JanDrska/FIRESPORT-WATCH/HW/Photo/HW/TEST_HW_2.jpeg

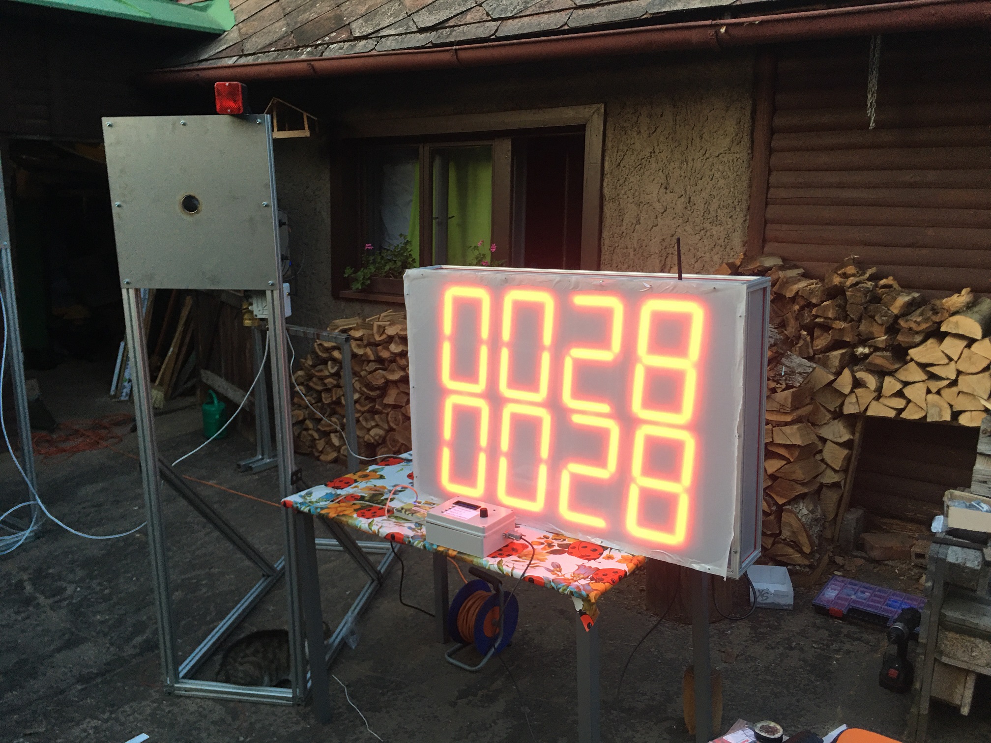
HW/Photo/HW/TEST_HW_2.jpeg
