JanDrska/FIRESPORT-WATCH/HW/Photo/HW/DETAIL NA UTESNENI.jpeg

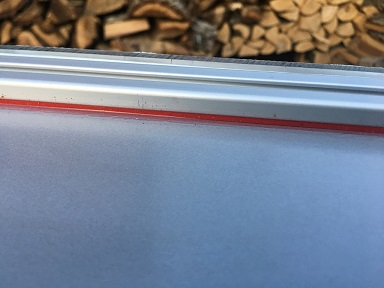
HW/Photo/HW/DETAIL NA UTESNENI.jpeg
