JanDrska/FIRESPORT-WATCH/README.md

# FIRESPORT-WATCH
OpenSource project based on arduino which allows better time measuring and adds some extras features.
