JanDrska/FIRESPORT-WATCH/HW/Eagle PCBs/7SEGMENT/7SEGMENT_SCH.png

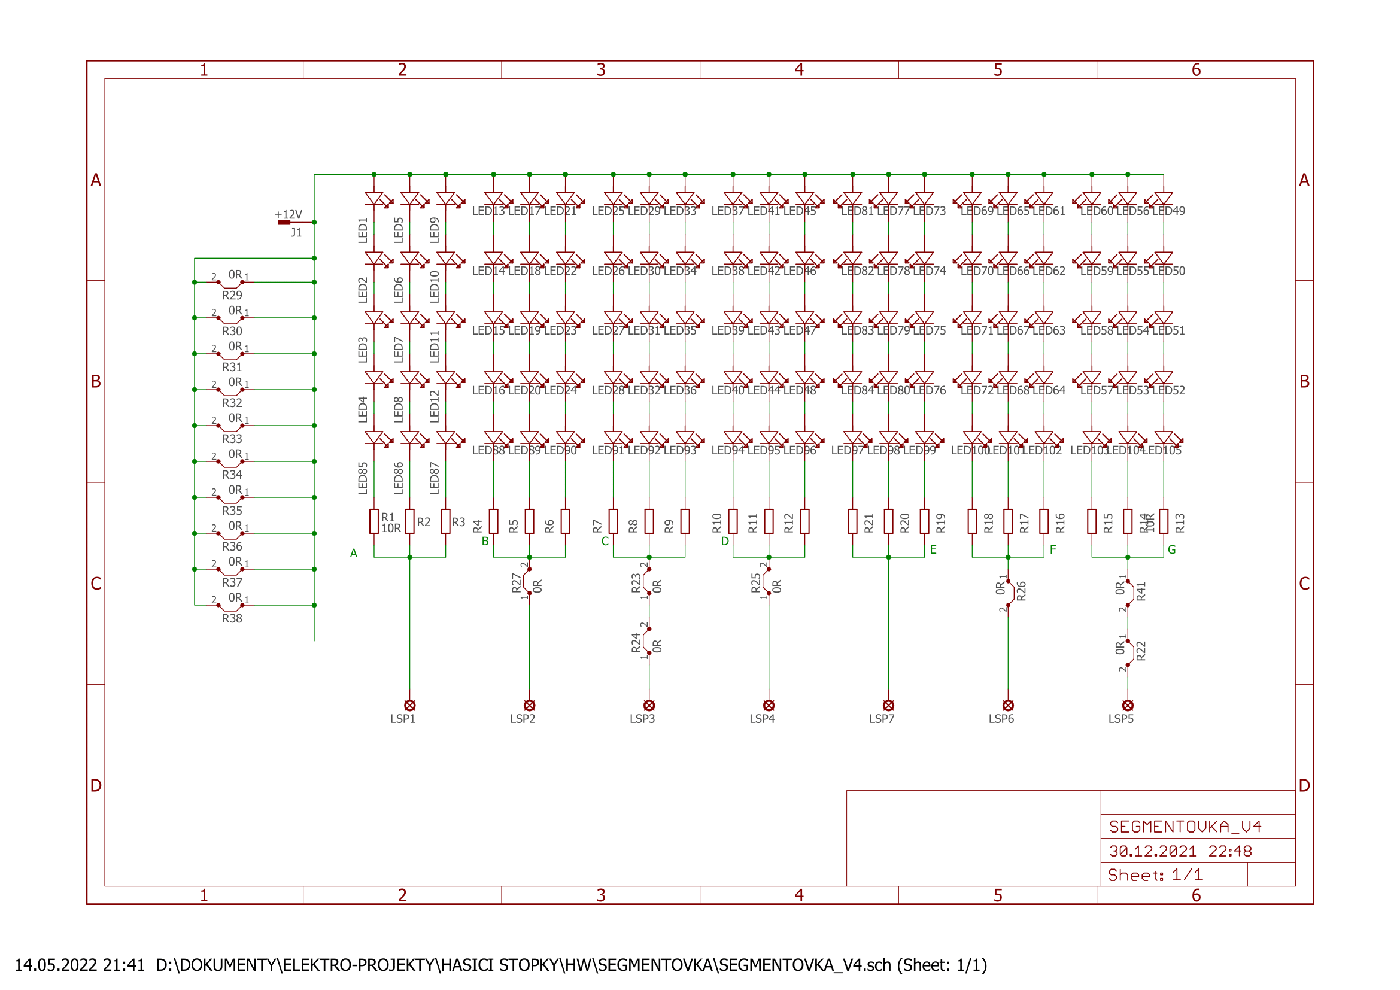
HW/Eagle PCBs/7SEGMENT/7SEGMENT_SCH.png
