JanDrska/FIRESPORT-WATCH/HW/Eagle PCBs/7SEGMENT/7SEGMENT_TOP.png

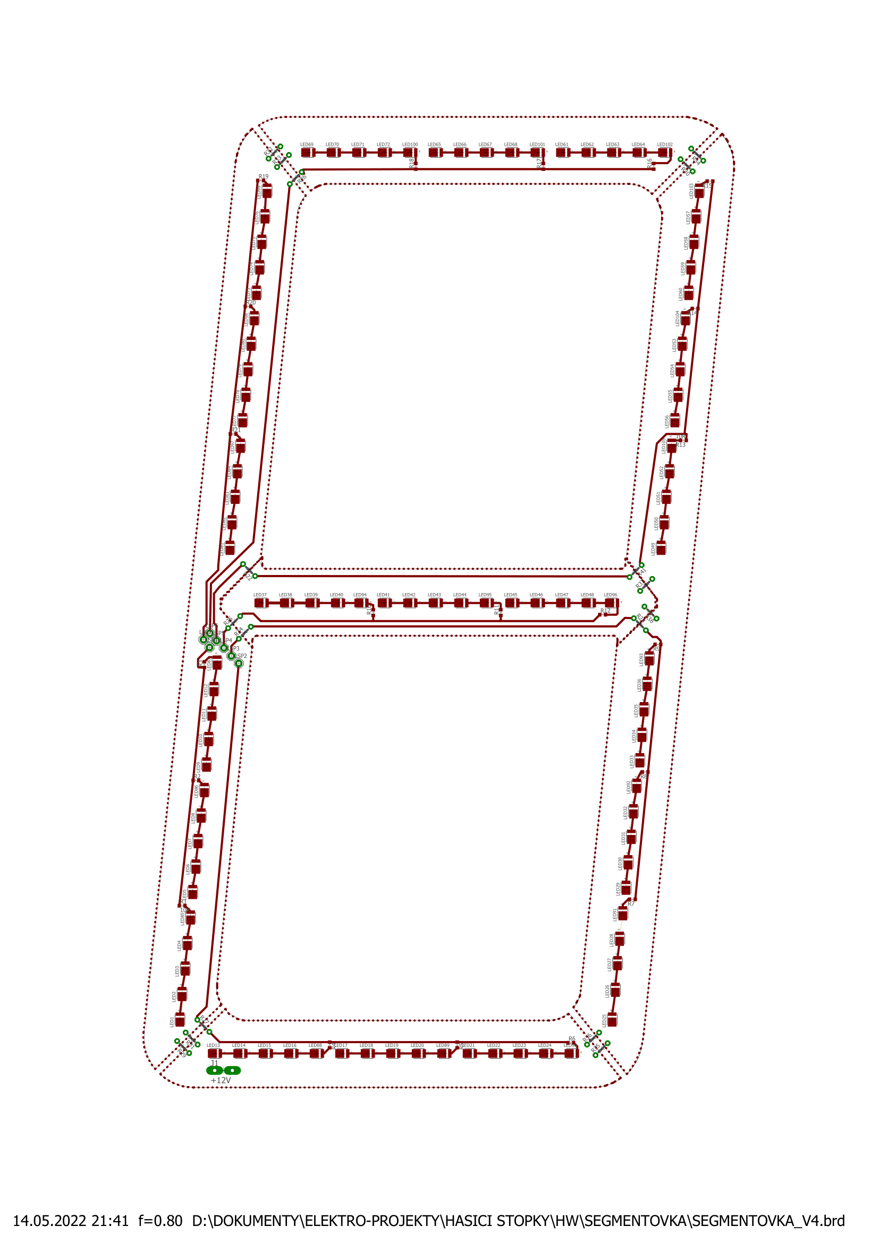
HW/Eagle PCBs/7SEGMENT/7SEGMENT_TOP.png
