JanDrska/FIRESPORT-WATCH/HW/Eagle PCBs/CONTROL_PANEL/CTRL_PANEL_SCH.png

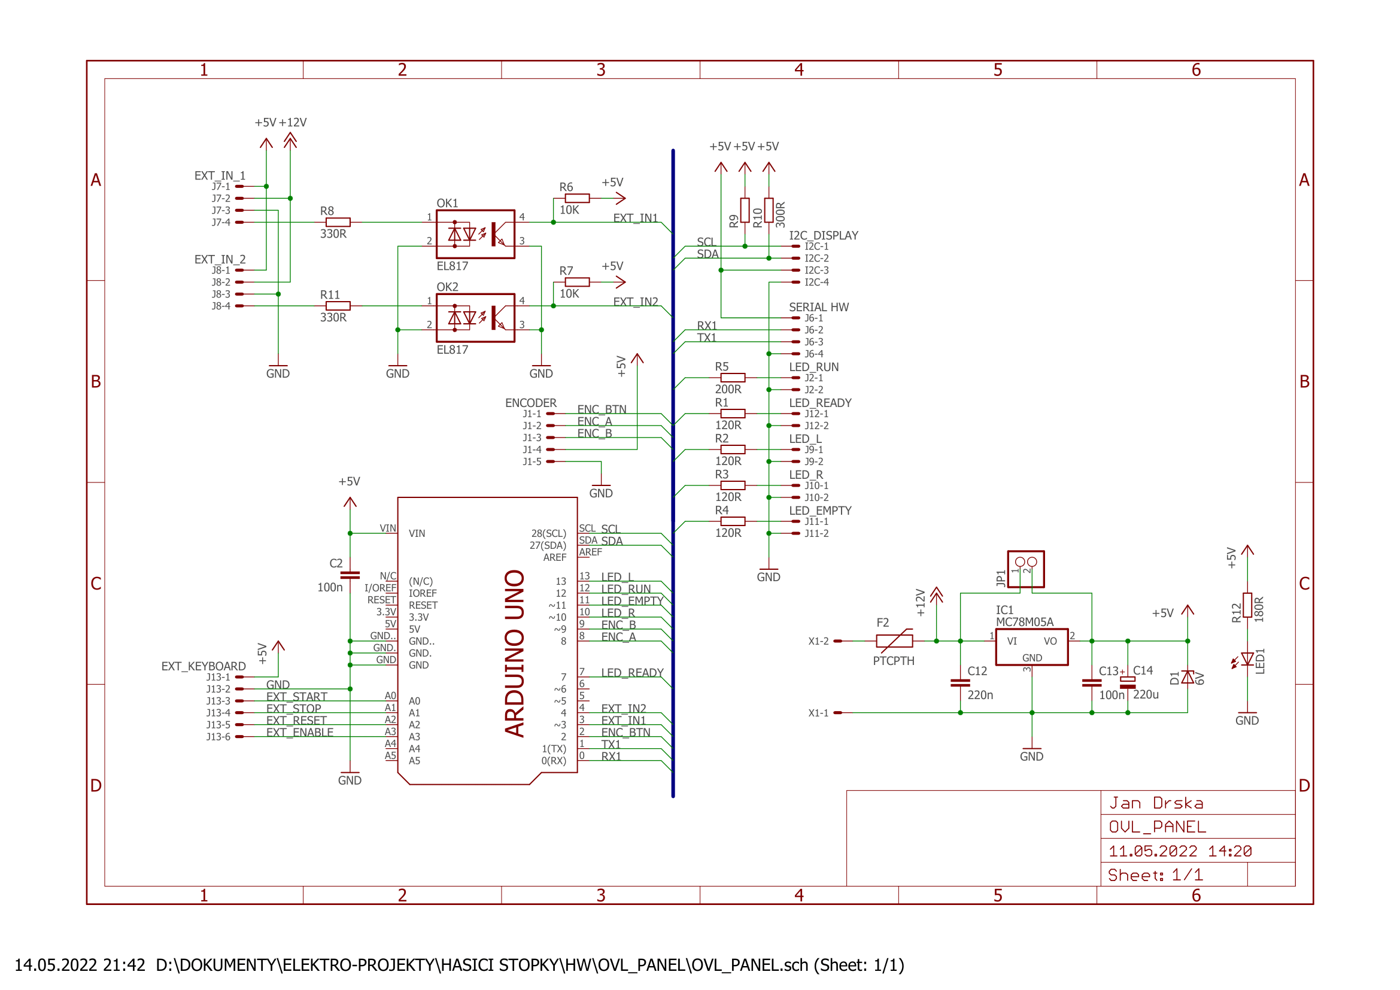
HW/Eagle PCBs/CONTROL_PANEL/CTRL_PANEL_SCH.png
