JanDrska/FIRESPORT-WATCH/HW/Eagle PCBs/CONTROL_PANEL/CTRL_PANEL_TOP_BOT.png

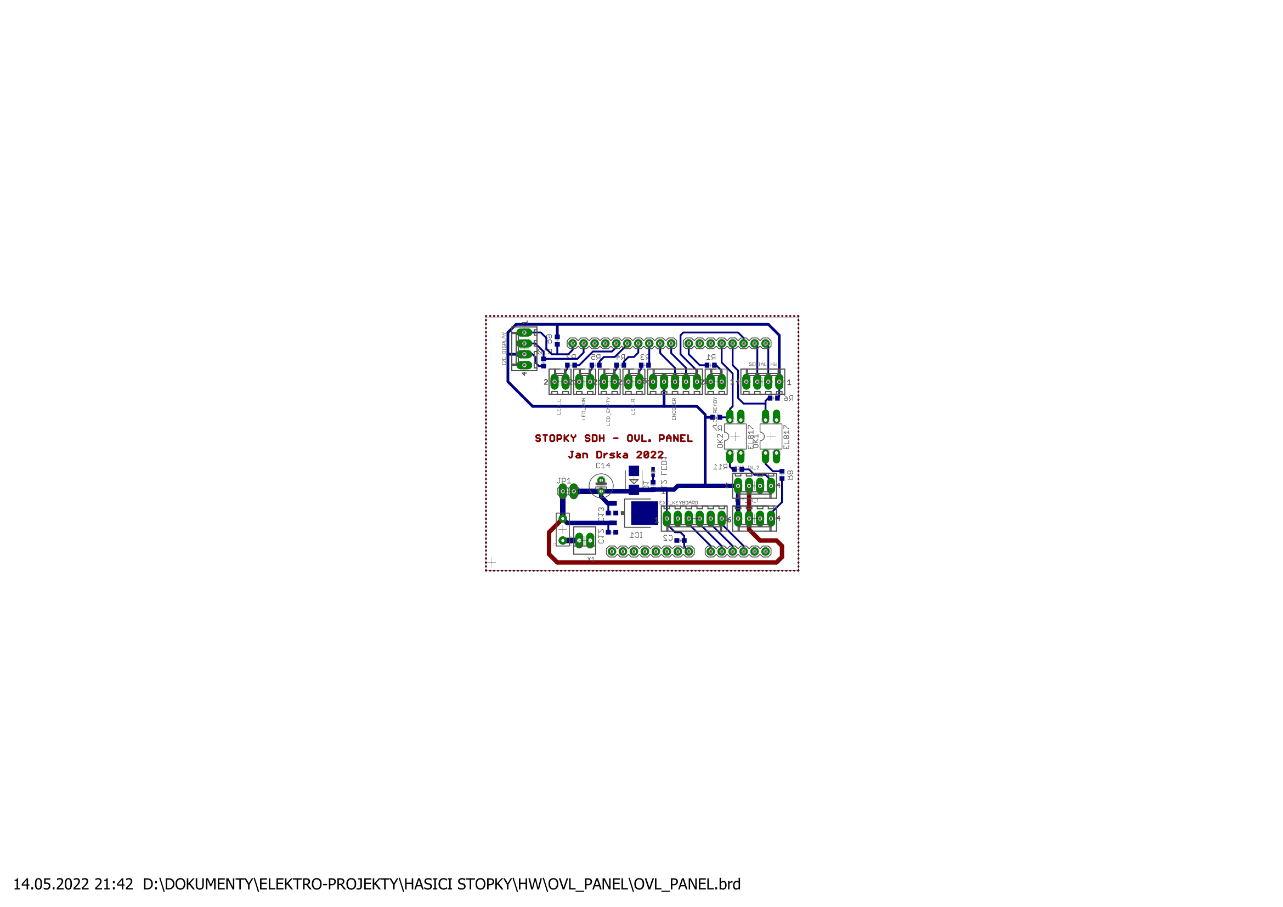
HW/Eagle PCBs/CONTROL_PANEL/CTRL_PANEL_TOP_BOT.png
