JanDrska/FIRESPORT-WATCH/HW/Eagle PCBs/I2C_MODULE/I2C_BOT_TOP.png

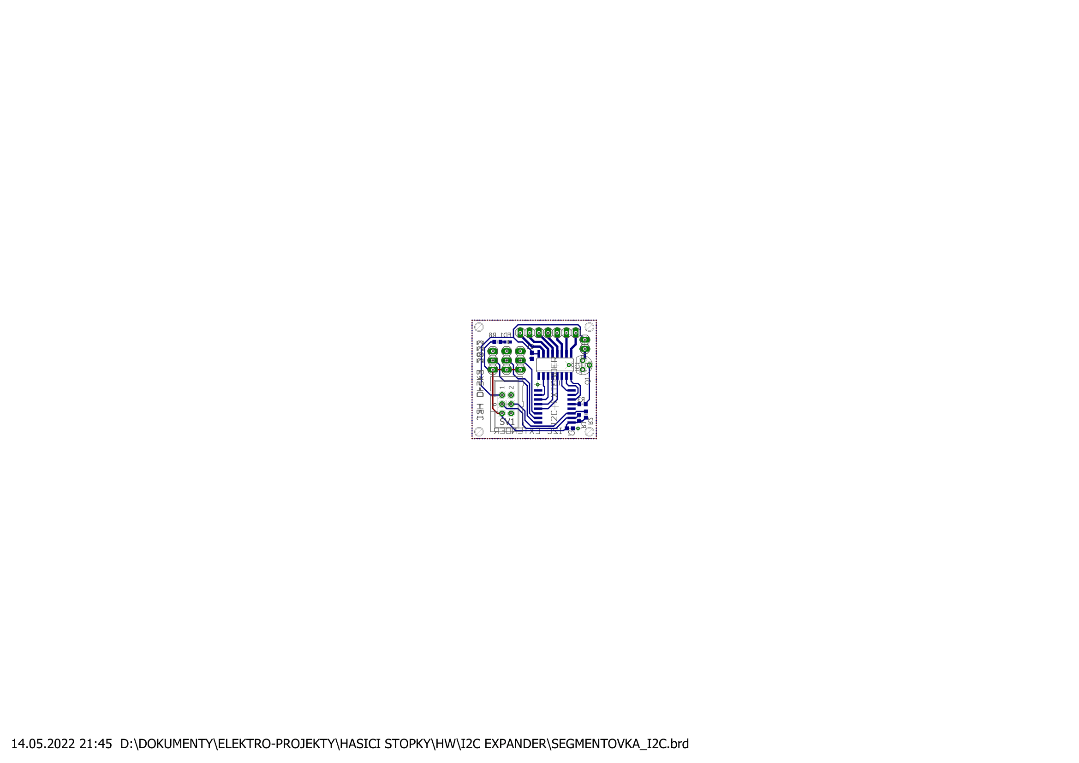
HW/Eagle PCBs/I2C_MODULE/I2C_BOT_TOP.png
