JanDrska/FIRESPORT-WATCH/HW/Eagle PCBs/I2C_MODULE/I2C_SCH.png

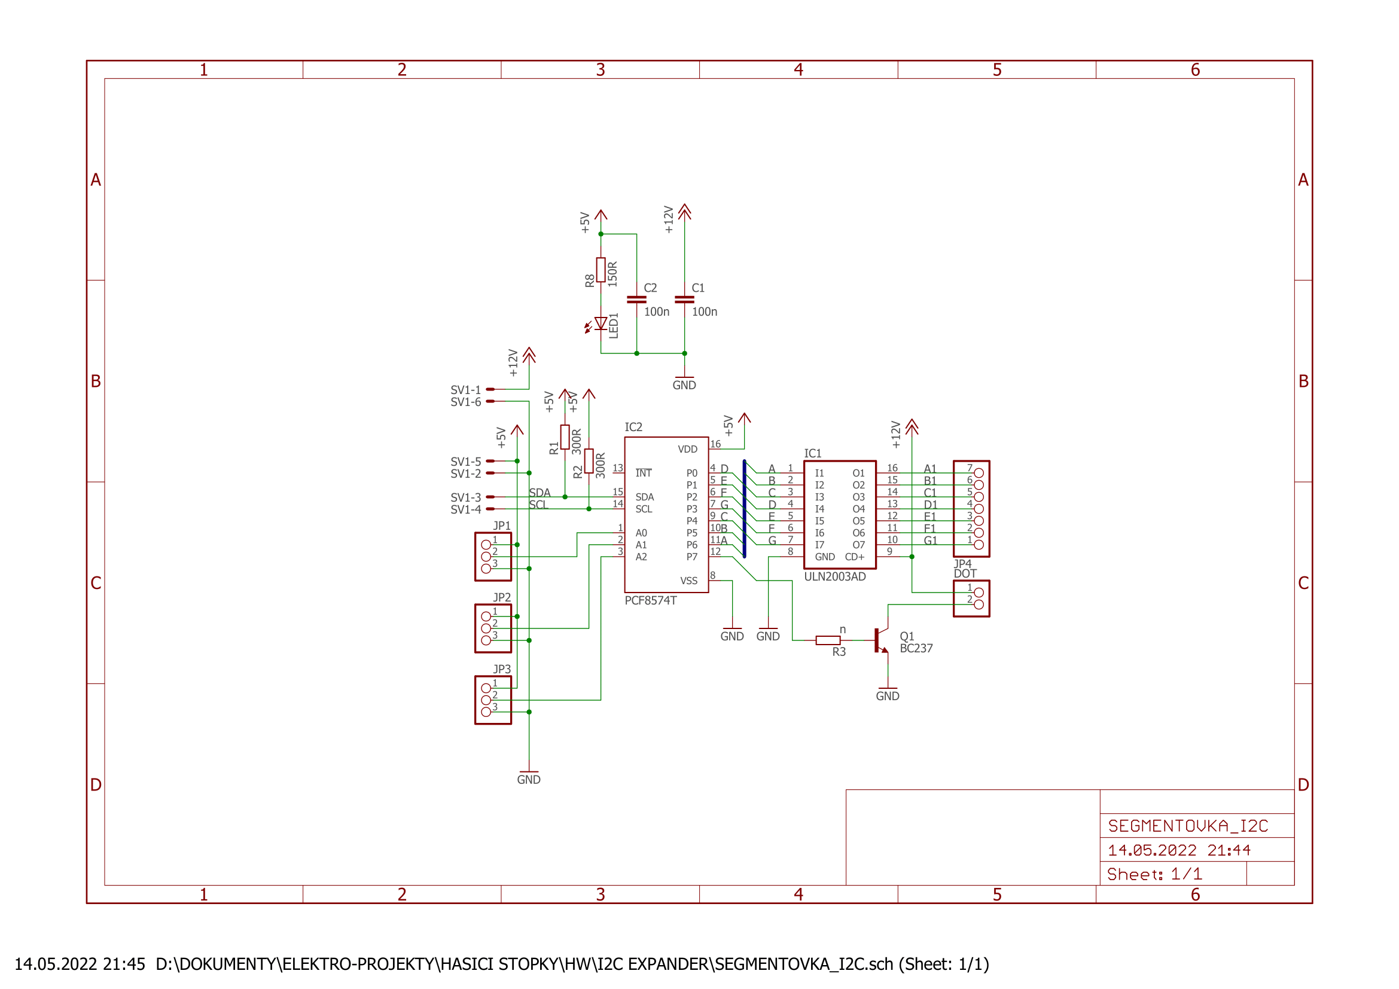
HW/Eagle PCBs/I2C_MODULE/I2C_SCH.png
