JanDrska/FIRESPORT-WATCH/HW/Eagle PCBs/MAIN UNIT/MAIN_UNIT_BOT.png

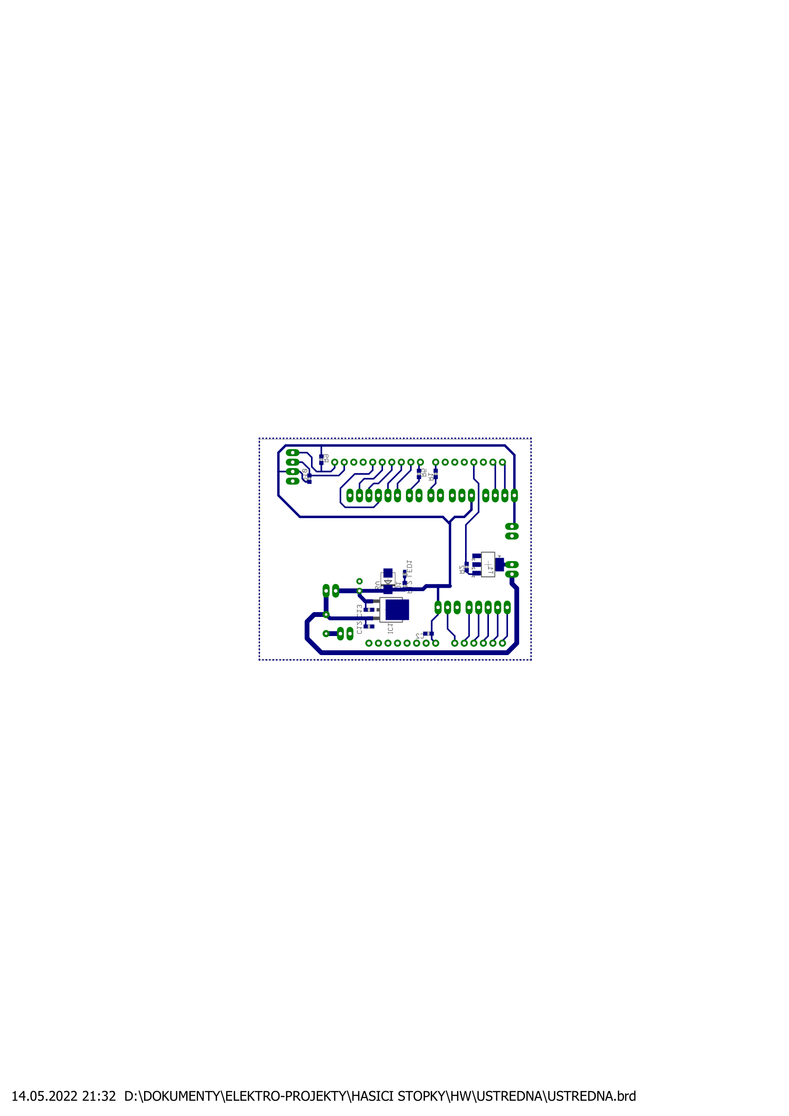
HW/Eagle PCBs/MAIN UNIT/MAIN_UNIT_BOT.png
