JanDrska/FIRESPORT-WATCH/HW/Eagle PCBs/MAIN UNIT/MAIN_UNIT_SCH.png

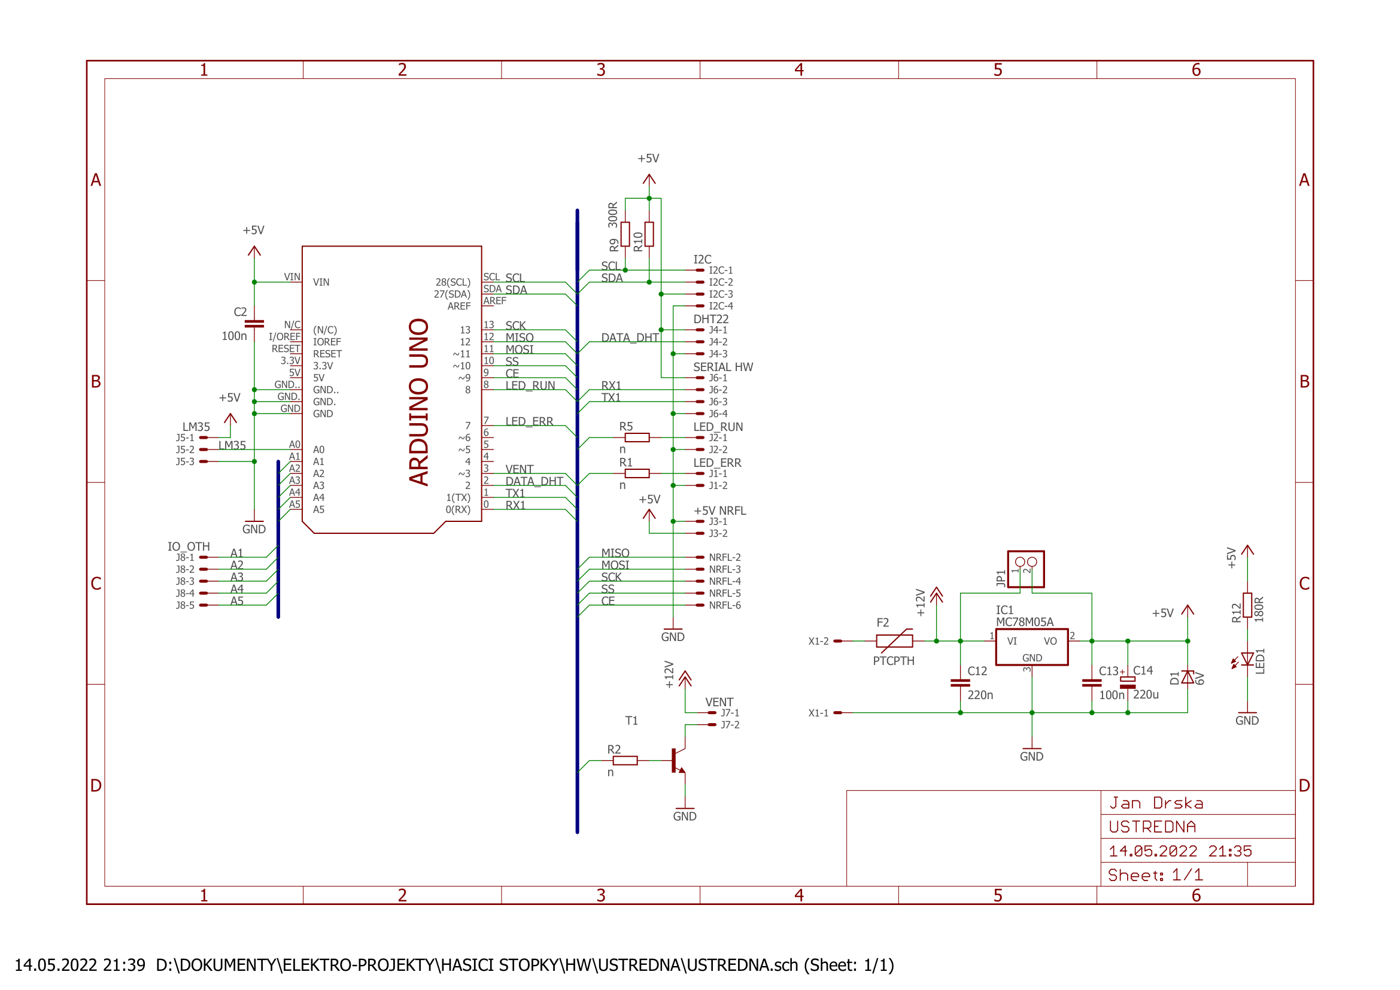
HW/Eagle PCBs/MAIN UNIT/MAIN_UNIT_SCH.png
