JanDrska/FIRESPORT-WATCH/HW/Eagle PCBs/TARGETS/TARGET_SCH.png

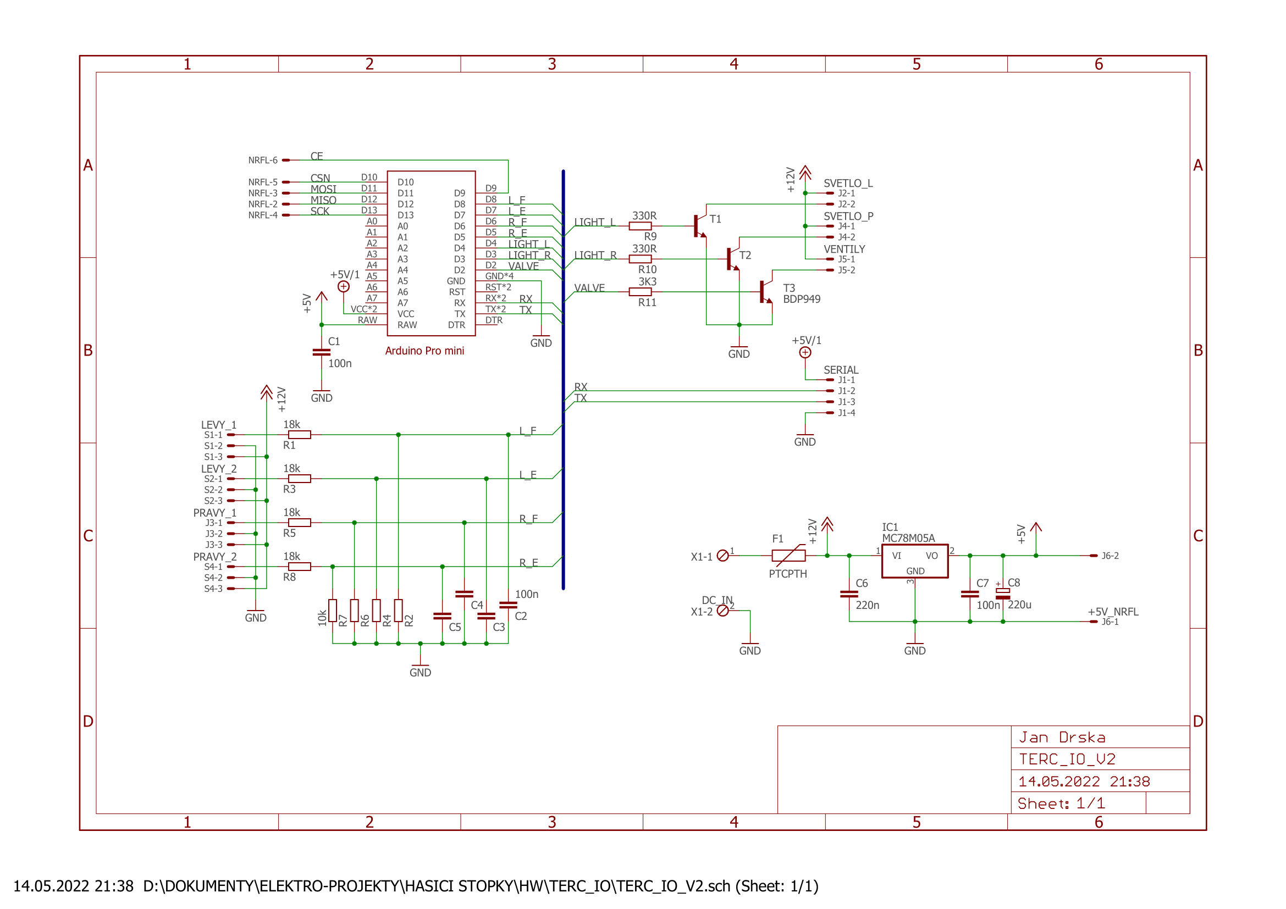
HW/Eagle PCBs/TARGETS/TARGET_SCH.png
