JanDrska/FIRESPORT-WATCH/HW/Photo/3D MODELS/DIFUZOR_V4.png

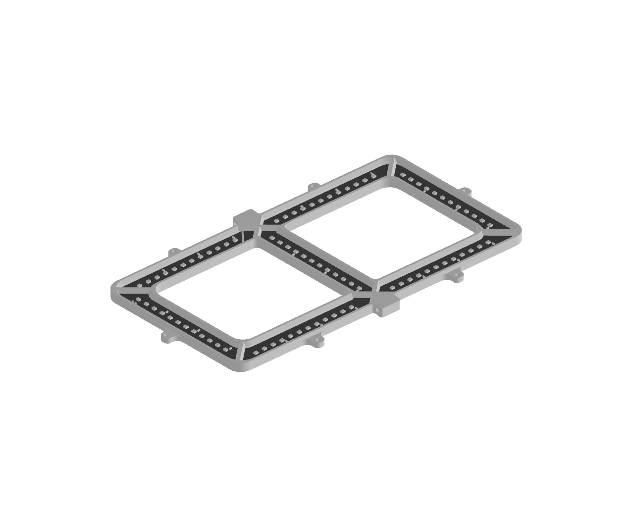
HW/Photo/3D MODELS/DIFUZOR_V4.png
