JanDrska/FIRESPORT-WATCH/HW/Photo/3D MODELS/OVLADACI_PANEL_KOMPLET.png

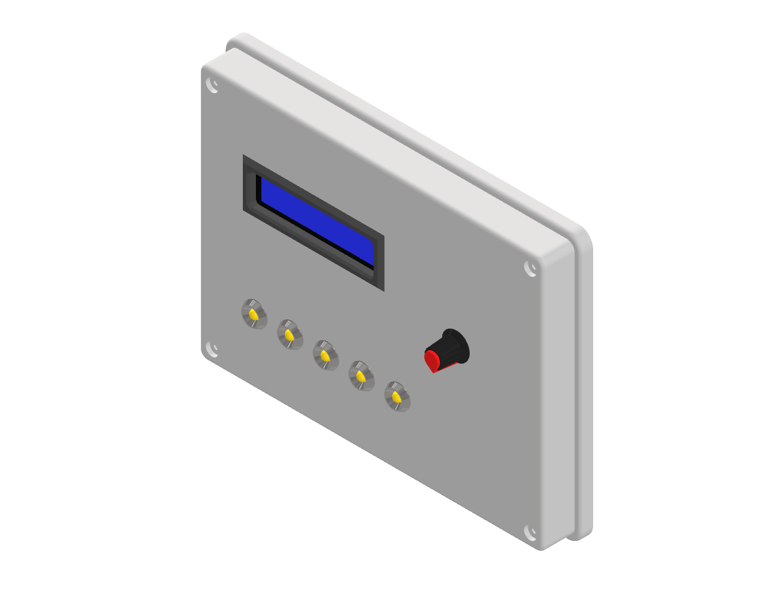
HW/Photo/3D MODELS/OVLADACI_PANEL_KOMPLET.png
