JanDrska/FIRESPORT-WATCH/HW/Photo/3D MODELS/PANEL_CELEK.png

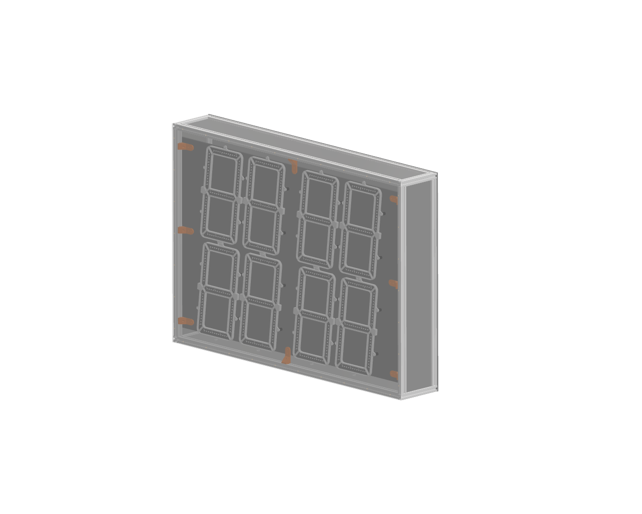
HW/Photo/3D MODELS/PANEL_CELEK.png
