JanDrska/FIRESPORT-WATCH/HW/Photo/3D MODELS/TERC2.png

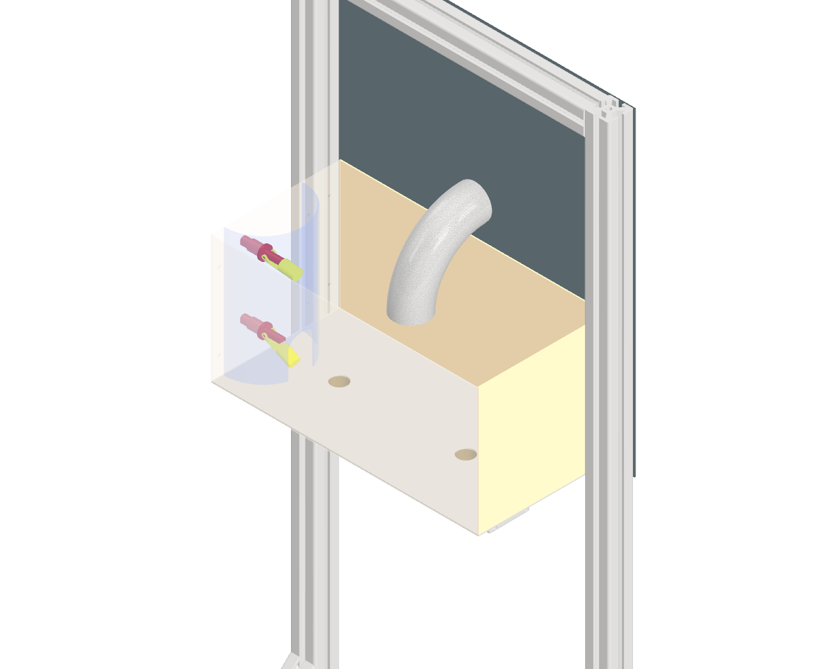
HW/Photo/3D MODELS/TERC2.png
