JanDrska/FIRESPORT-WATCH/HW/Photo/3D MODELS/TERC.png

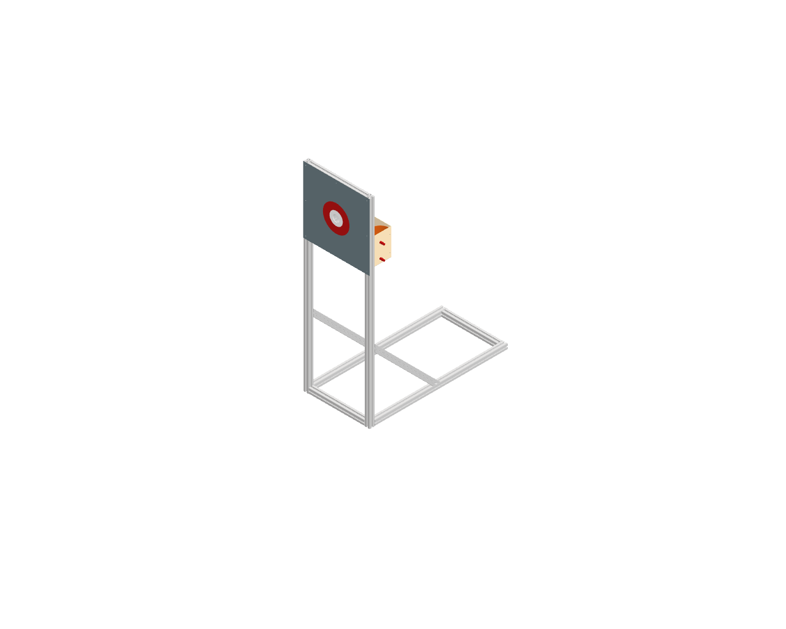
HW/Photo/3D MODELS/TERC.png
