JanDrska/FIRESPORT-WATCH/HW/Photo/HW/DIGITY S DIFUZORY.jpeg

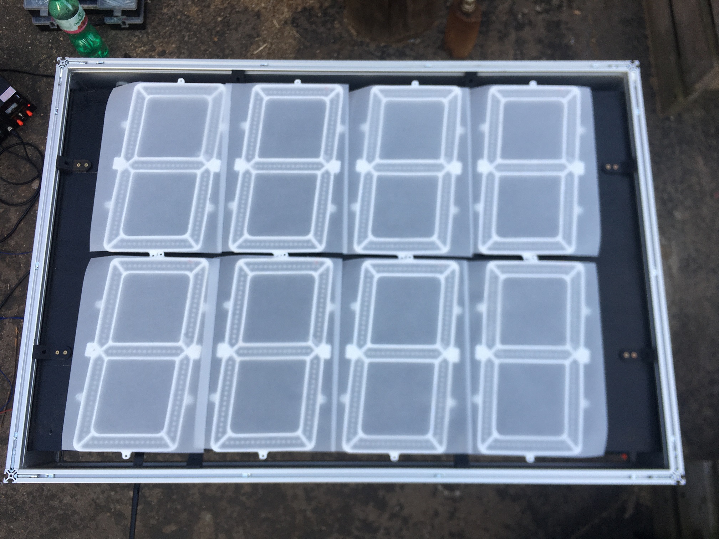
HW/Photo/HW/DIGITY S DIFUZORY.jpeg
