JanDrska/FIRESPORT-WATCH/HW/Photo/HW/DISPLEJ BEZ FOLIE.jpeg

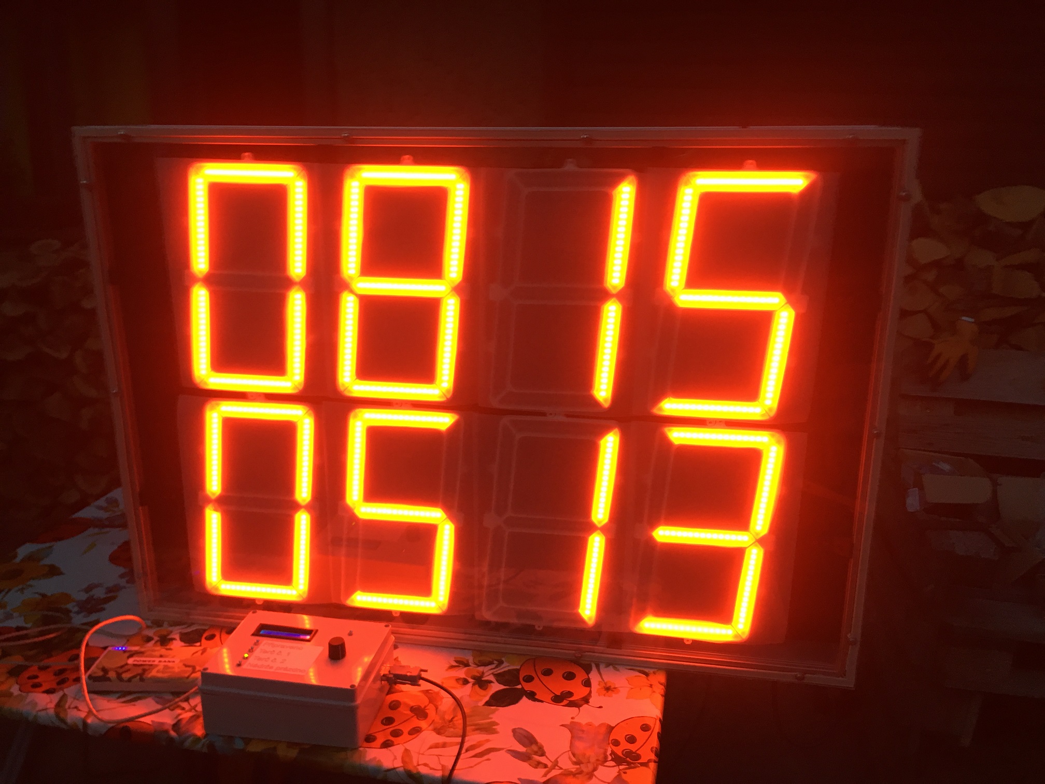
HW/Photo/HW/DISPLEJ BEZ FOLIE.jpeg
