JanDrska/FIRESPORT-WATCH/HW/Photo/HW/NADRZE PRI MONTAZI.jpeg

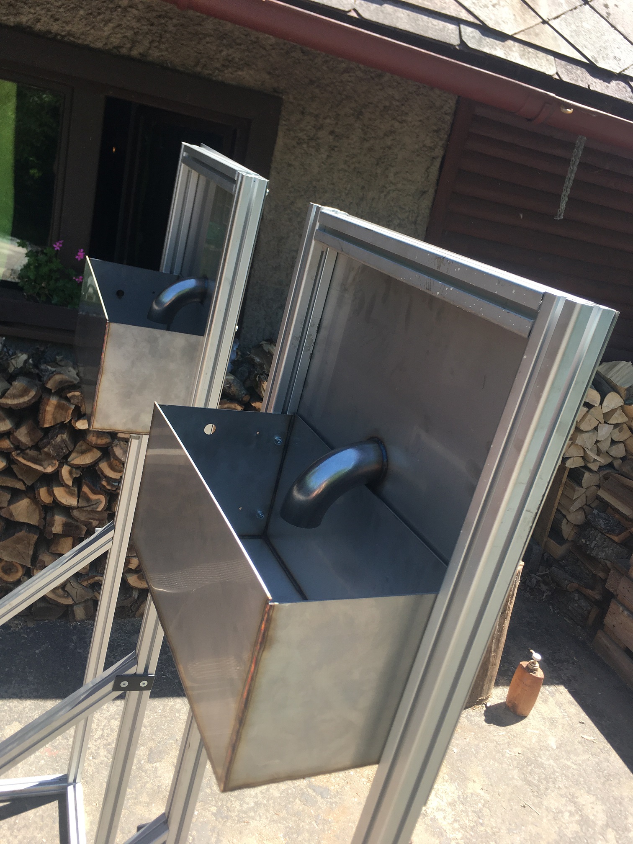
HW/Photo/HW/NADRZE PRI MONTAZI.jpeg
