JanDrska/FIRESPORT-WATCH/HW/Photo/HW/POHLED NA PRIDELANY ZADNI KRYCI PLECH.jpeg

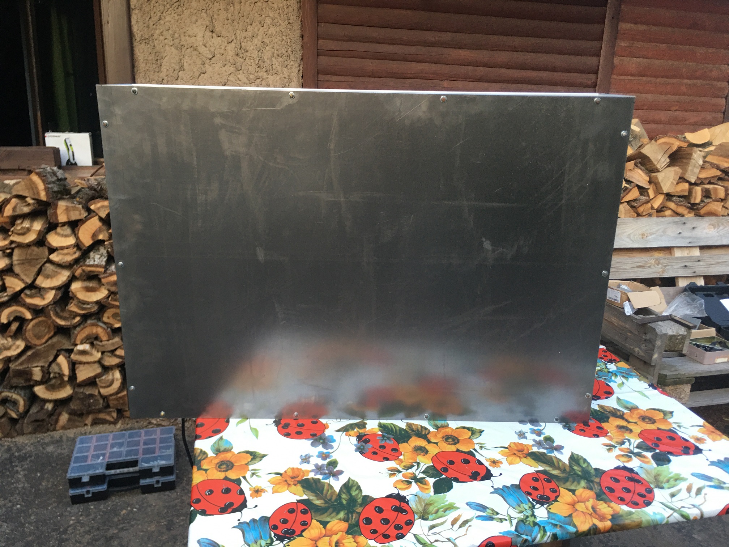
HW/Photo/HW/POHLED NA PRIDELANY ZADNI KRYCI PLECH.jpeg
