JanDrska/FIRESPORT-WATCH/HW/Photo/HW/UKAZKA UTESNENI PLEXI.jpeg

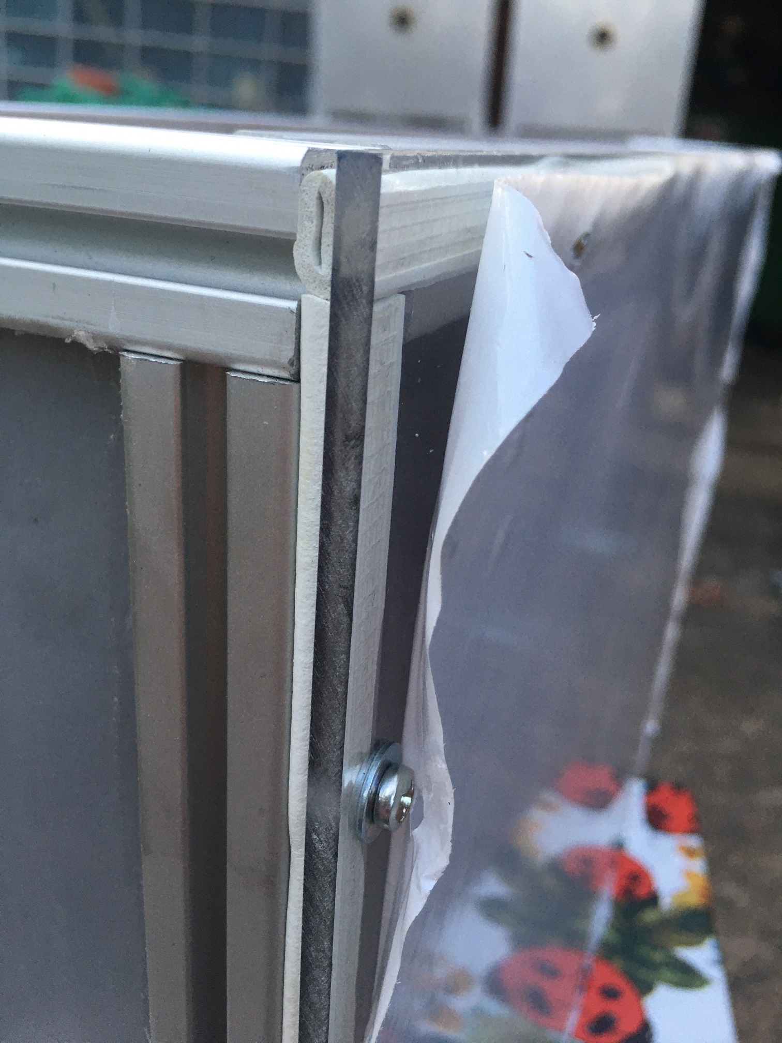
HW/Photo/HW/UKAZKA UTESNENI PLEXI.jpeg
