JanDrska/FIRESPORT-WATCH/HW/Photo/HW/VNITREK DISPLEJE.jpeg

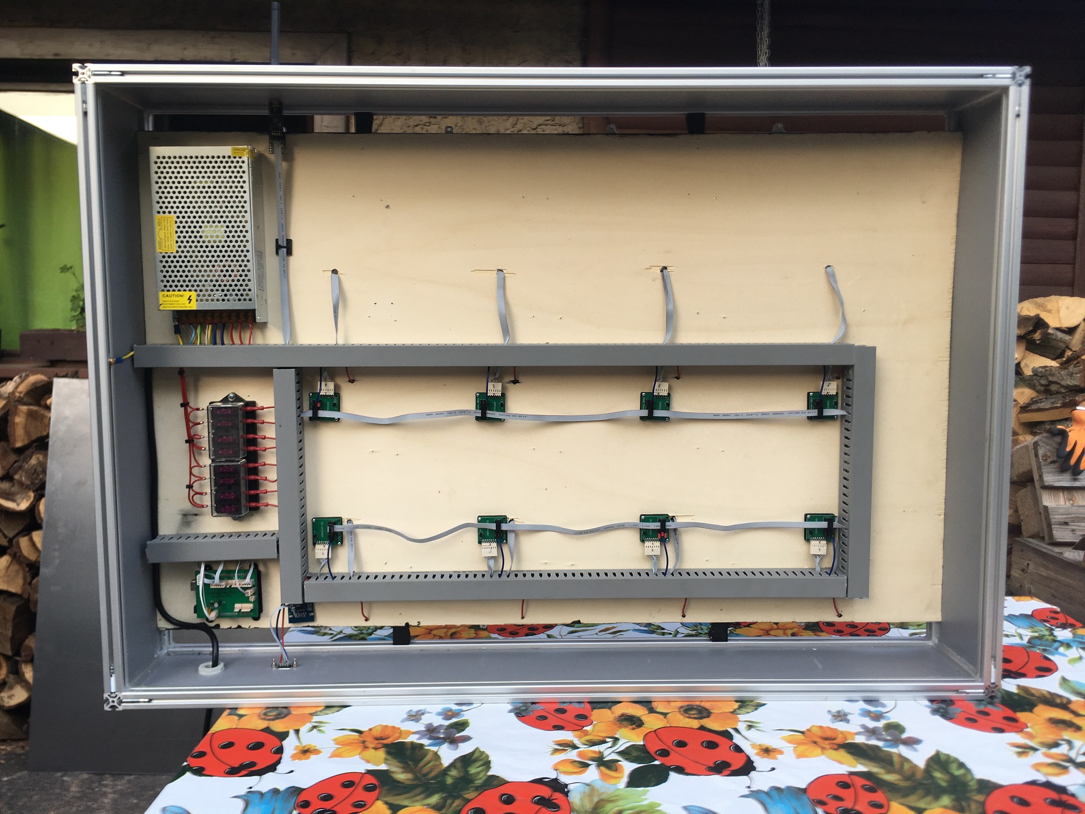
HW/Photo/HW/VNITREK DISPLEJE.jpeg
