JanDrska/FIRESPORT-WATCH/HW/Shematics & diagrams/BLOCK SCHEMATICS/BLOKOVE SCHEMA USTREDNA.png

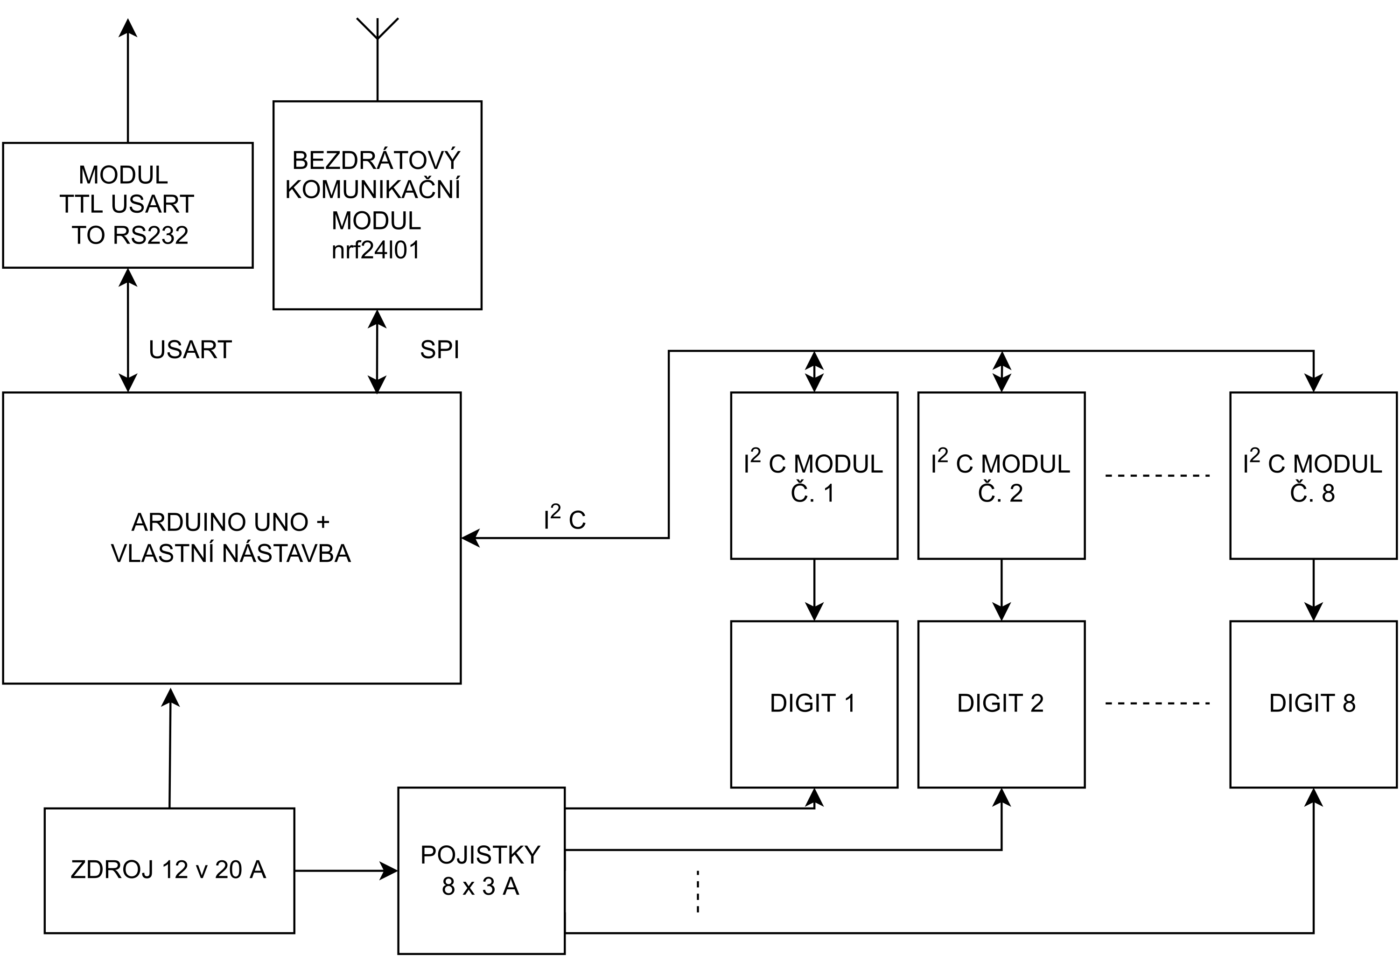
HW/Shematics & diagrams/BLOCK SCHEMATICS/BLOKOVE SCHEMA USTREDNA.png
