JanDrska/FIRESPORT-WATCH/HW/Shematics & diagrams/BLOCK SCHEMATICS/OVLADACI PANEL BLOKOVE SCHEMA.png

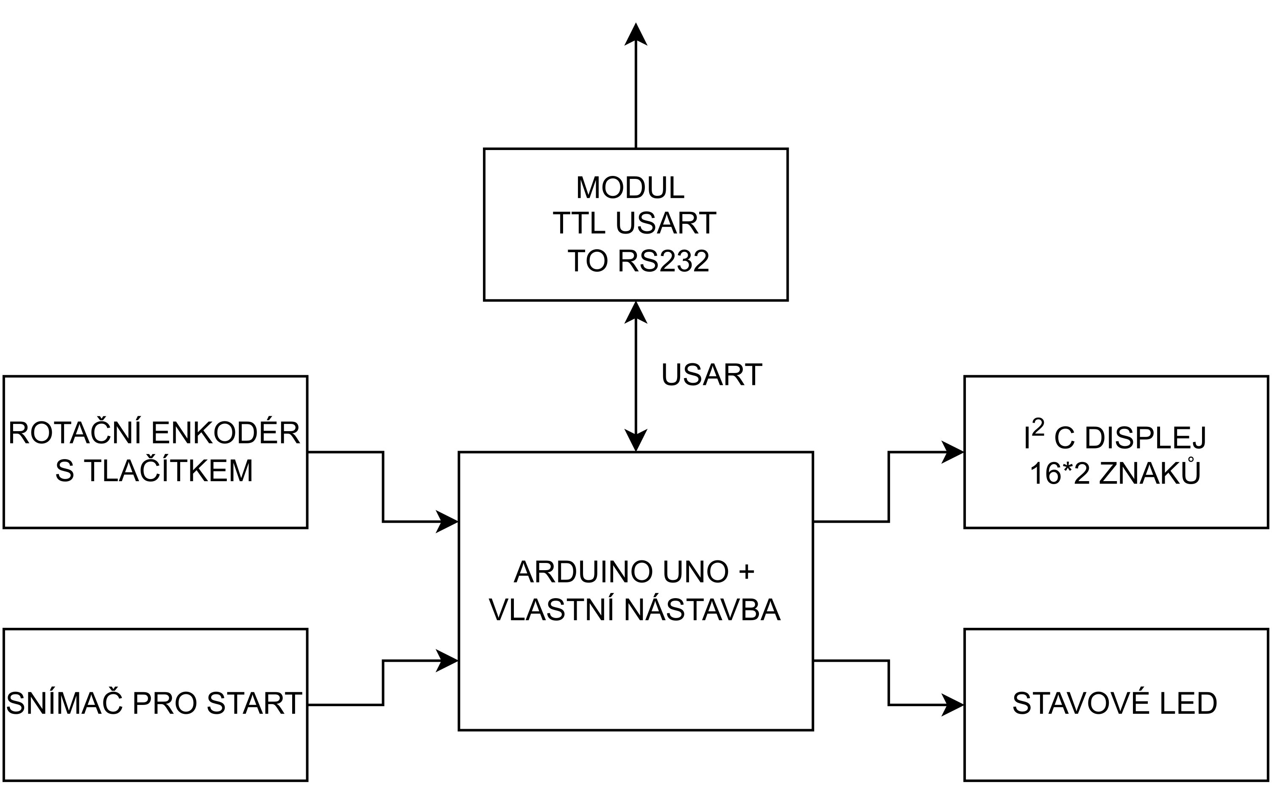
HW/Shematics & diagrams/BLOCK SCHEMATICS/OVLADACI PANEL BLOKOVE SCHEMA.png
