JanDrska/FIRESPORT-WATCH/HW/Shematics & diagrams/BLOCK SCHEMATICS/TERC BLOKOVE SCHEMA.png

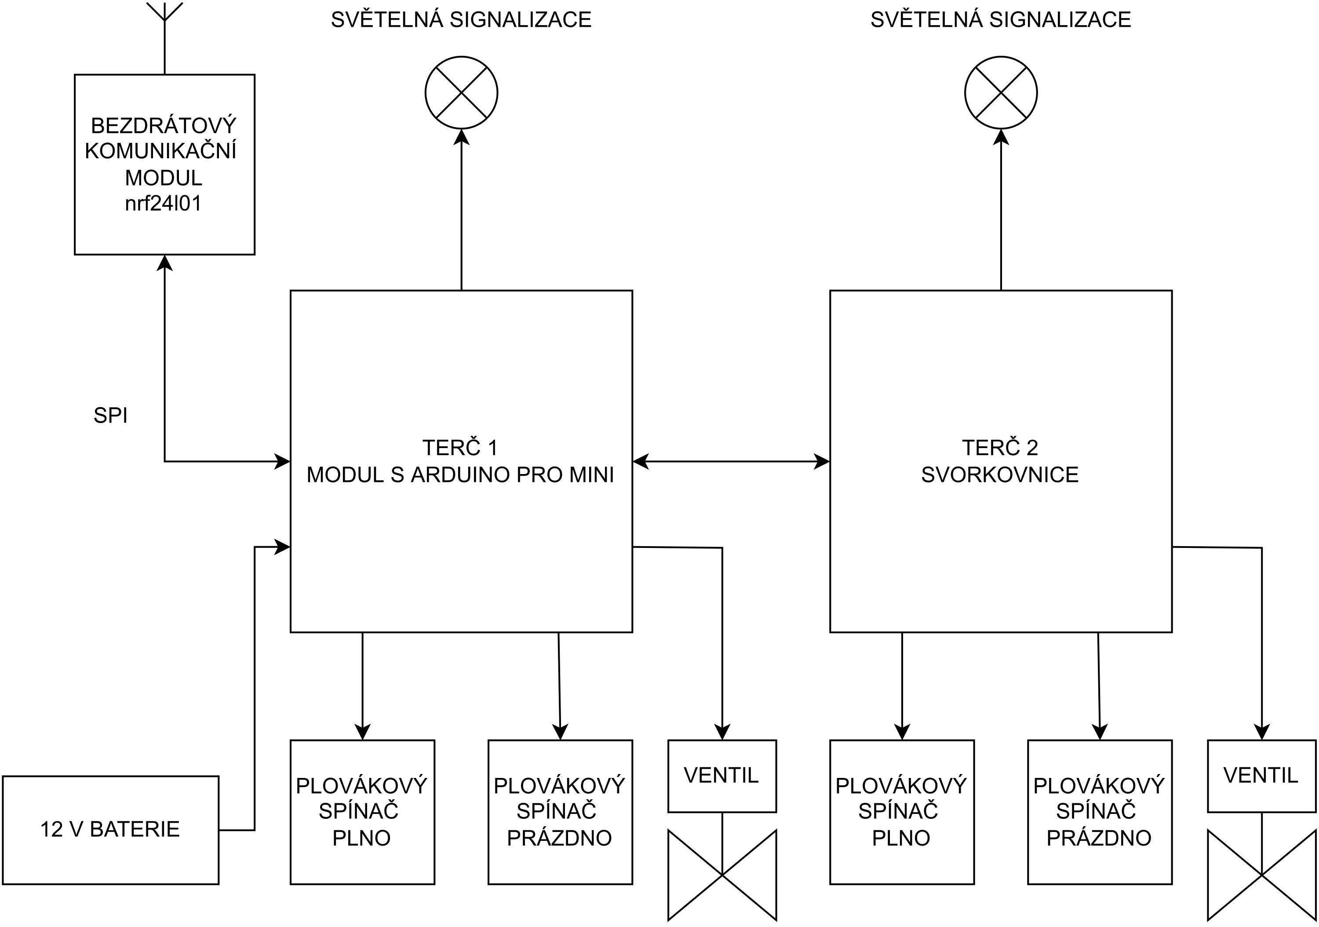
HW/Shematics & diagrams/BLOCK SCHEMATICS/TERC BLOKOVE SCHEMA.png
