JanDrska/FIRESPORT-WATCH/HW/Shematics & diagrams/FIRESPORT SCHEME.png

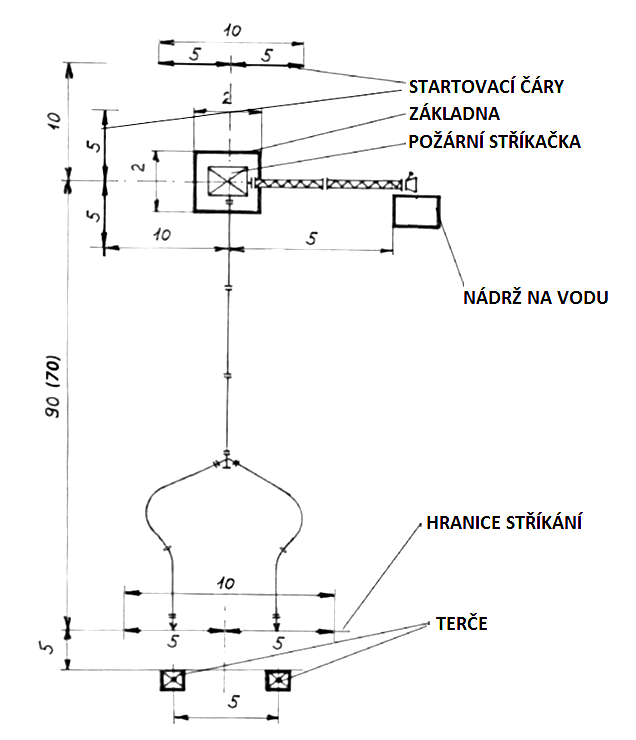
HW/Shematics & diagrams/FIRESPORT SCHEME.png
