JanDrska/FIRESPORT-WATCH/HW/Shematics & diagrams/PROGRAMM DIAGRAMS/OVLADACI PANEL VD.png

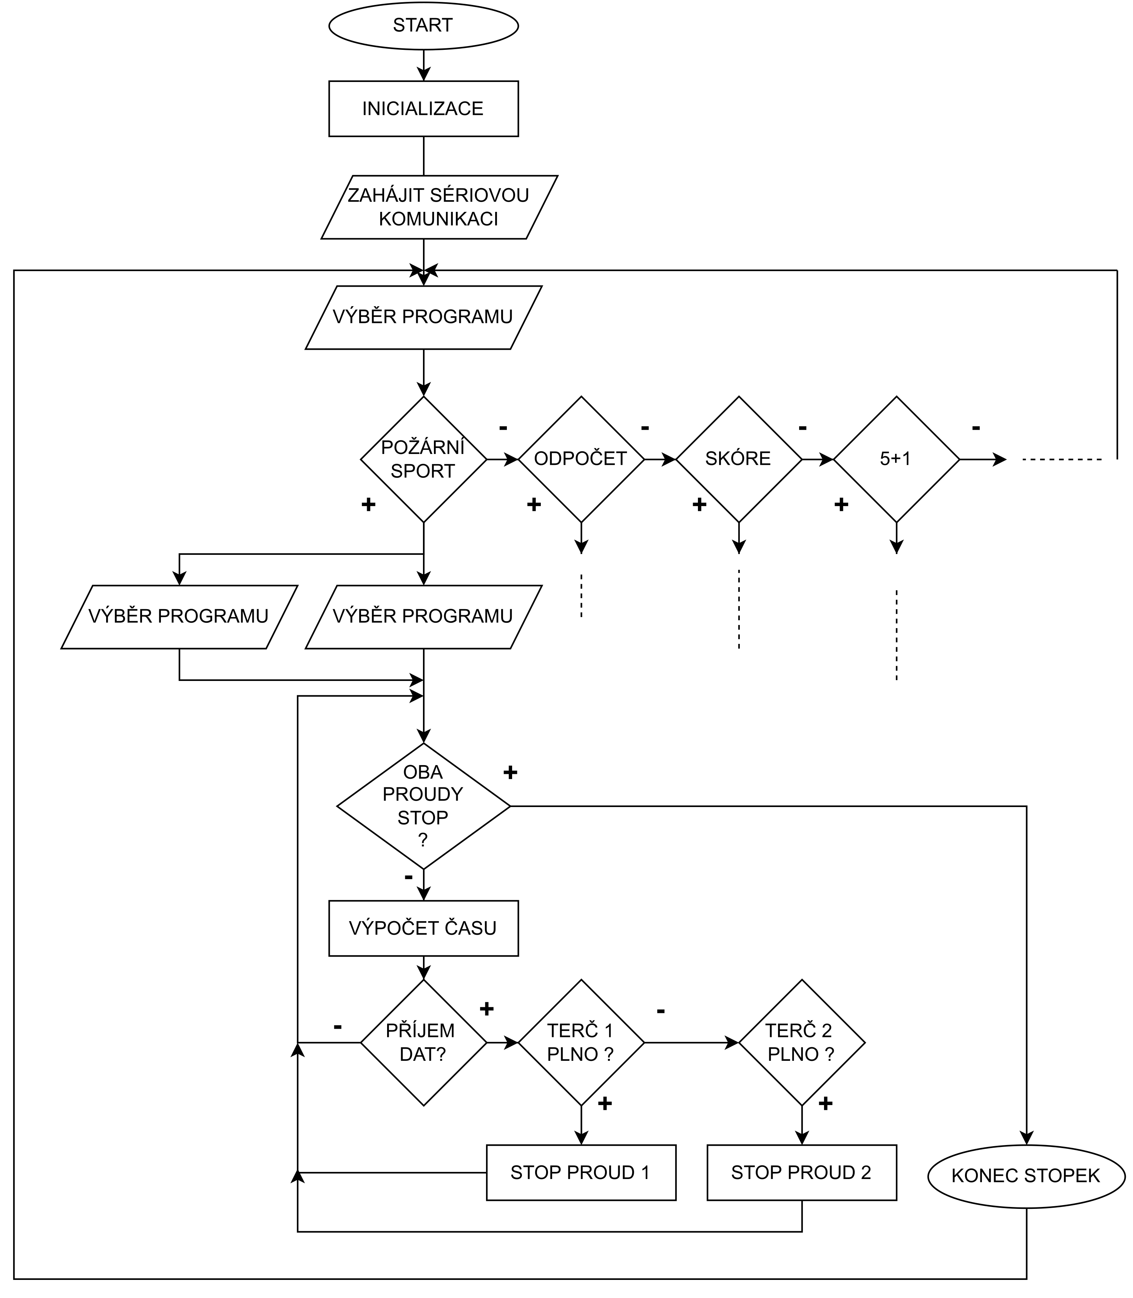
HW/Shematics & diagrams/PROGRAMM DIAGRAMS/OVLADACI PANEL VD.png
