JanDrska/FIRESPORT-WATCH/HW/Shematics & diagrams/PROGRAMM DIAGRAMS/TERCE VD.png

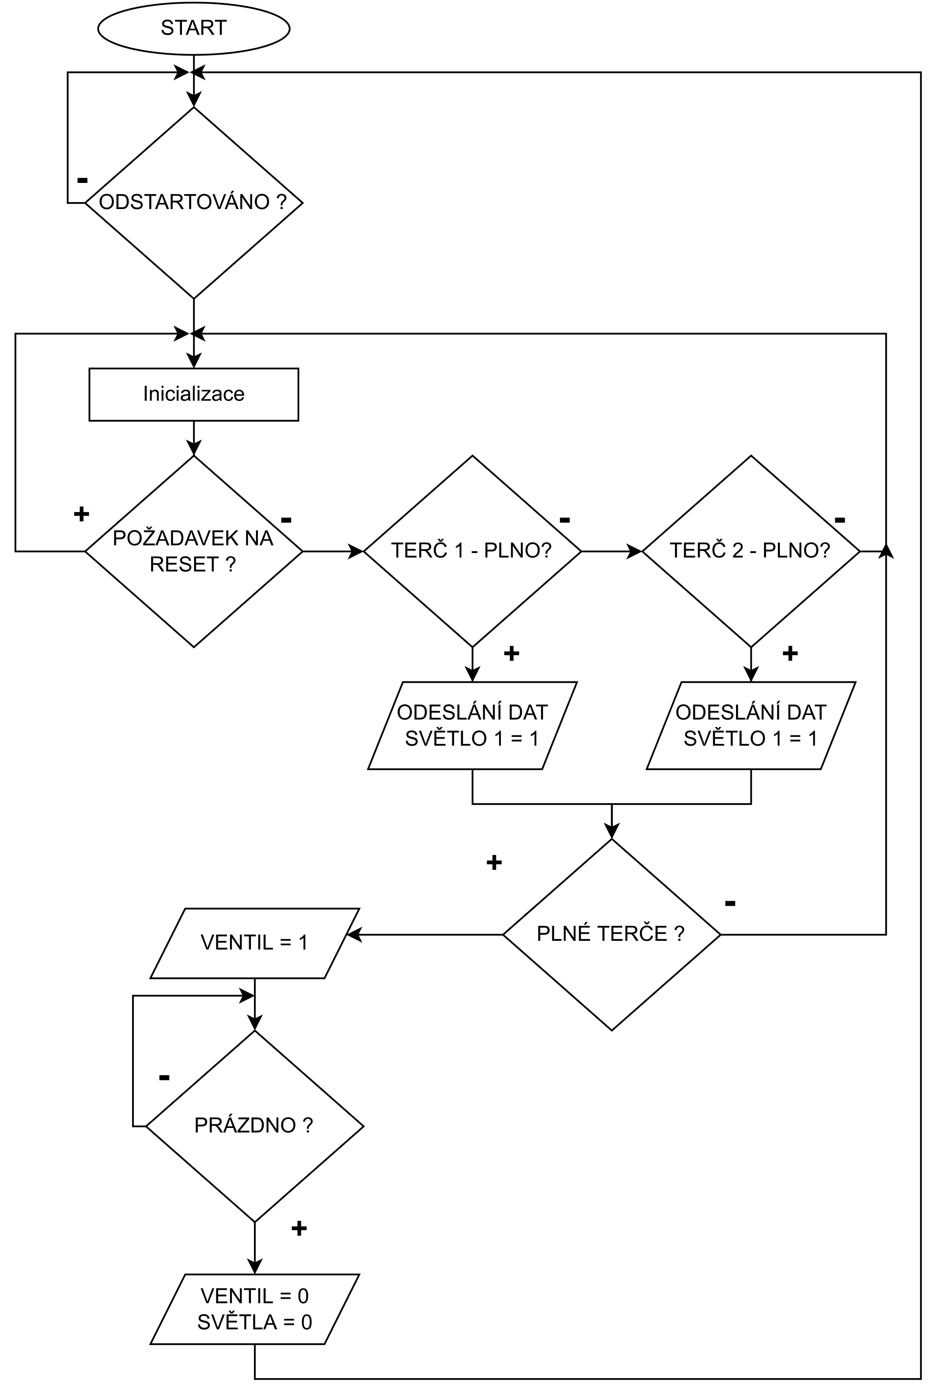
HW/Shematics & diagrams/PROGRAMM DIAGRAMS/TERCE VD.png
