JanDrska/FIRESPORT-WATCH/HW/Shematics & diagrams/PROGRAMM DIAGRAMS/USTREDNA VD.png

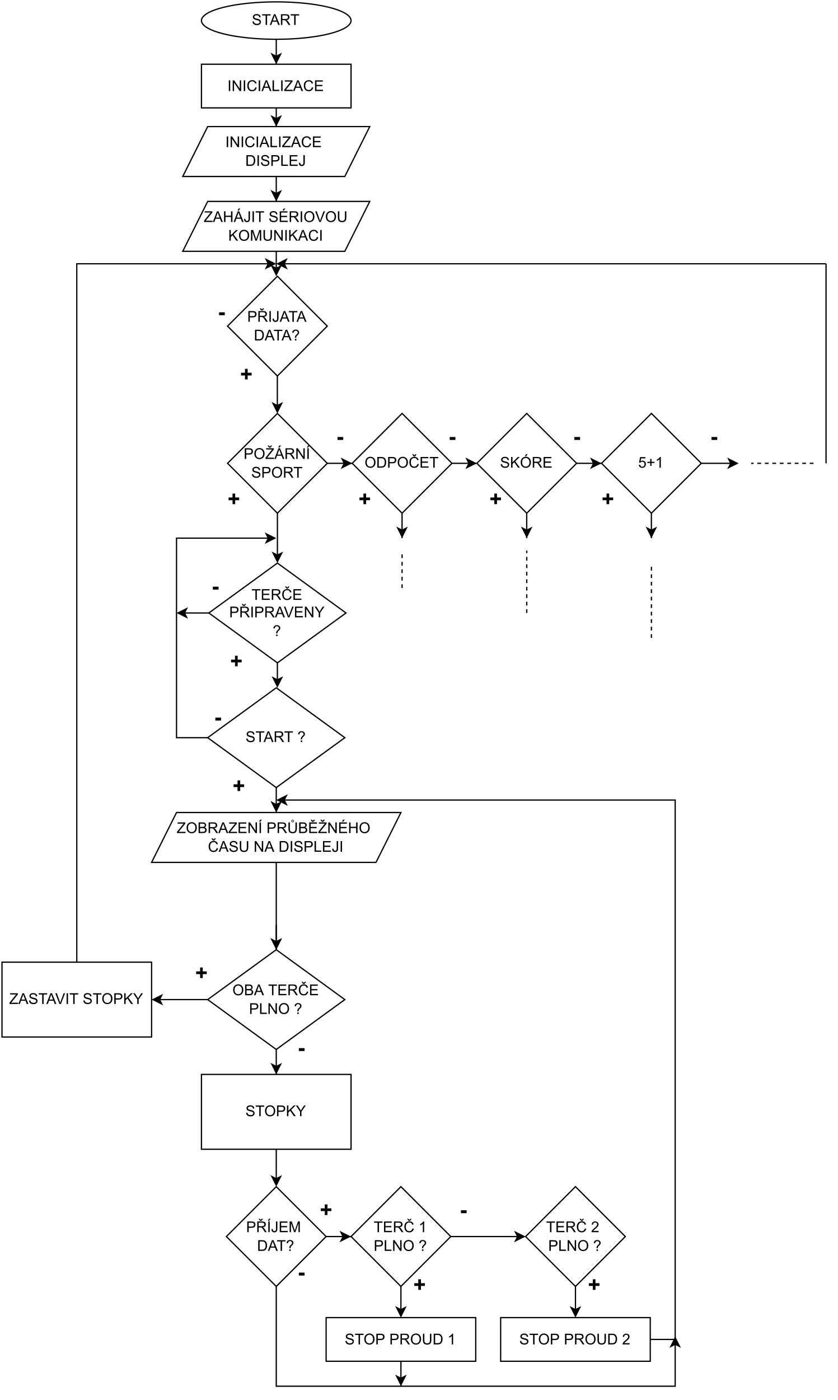
HW/Shematics & diagrams/PROGRAMM DIAGRAMS/USTREDNA VD.png
