JanDrska/FIRESPORT-WATCH/HW/Shematics & diagrams/snimac.png

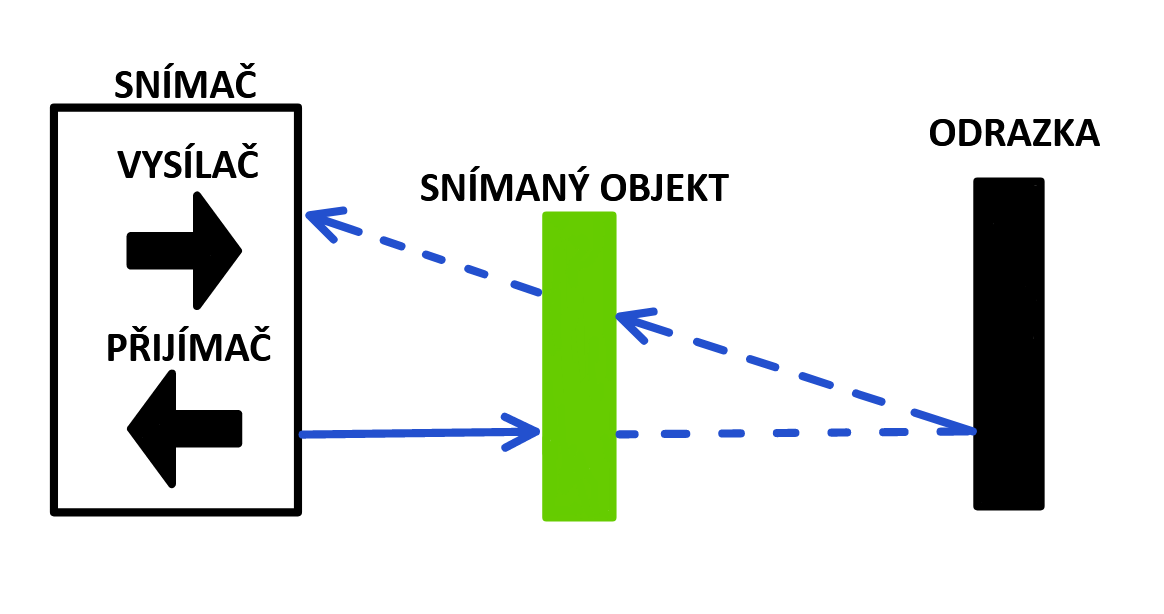
HW/Shematics & diagrams/snimac.png
