JanDrska/FIRESPORT-WATCH/HW/Shematics & diagrams/tercV2.png

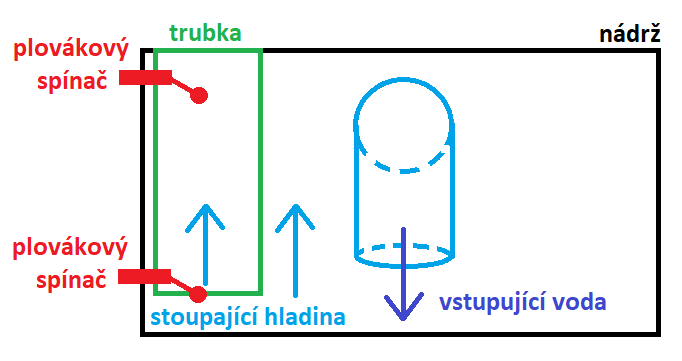
HW/Shematics & diagrams/tercV2.png
