JanDrska/FIRESPORT-WATCH/HW/Eagle PCBs/7SEGMENT/7SEGMENT_TOP.pdf

LED70 | LED71 | LED72 LED⁷³ LED⁷⁴ LED⁷⁵ LED⁷⁶ LED⁷⁷ LED⁷⁸ LED⁷⁹ LED⁸ | LED⁸⁰ LED⁸¹ LED⁸² LED⁸³ LED⁸⁴ LED⁹

R14

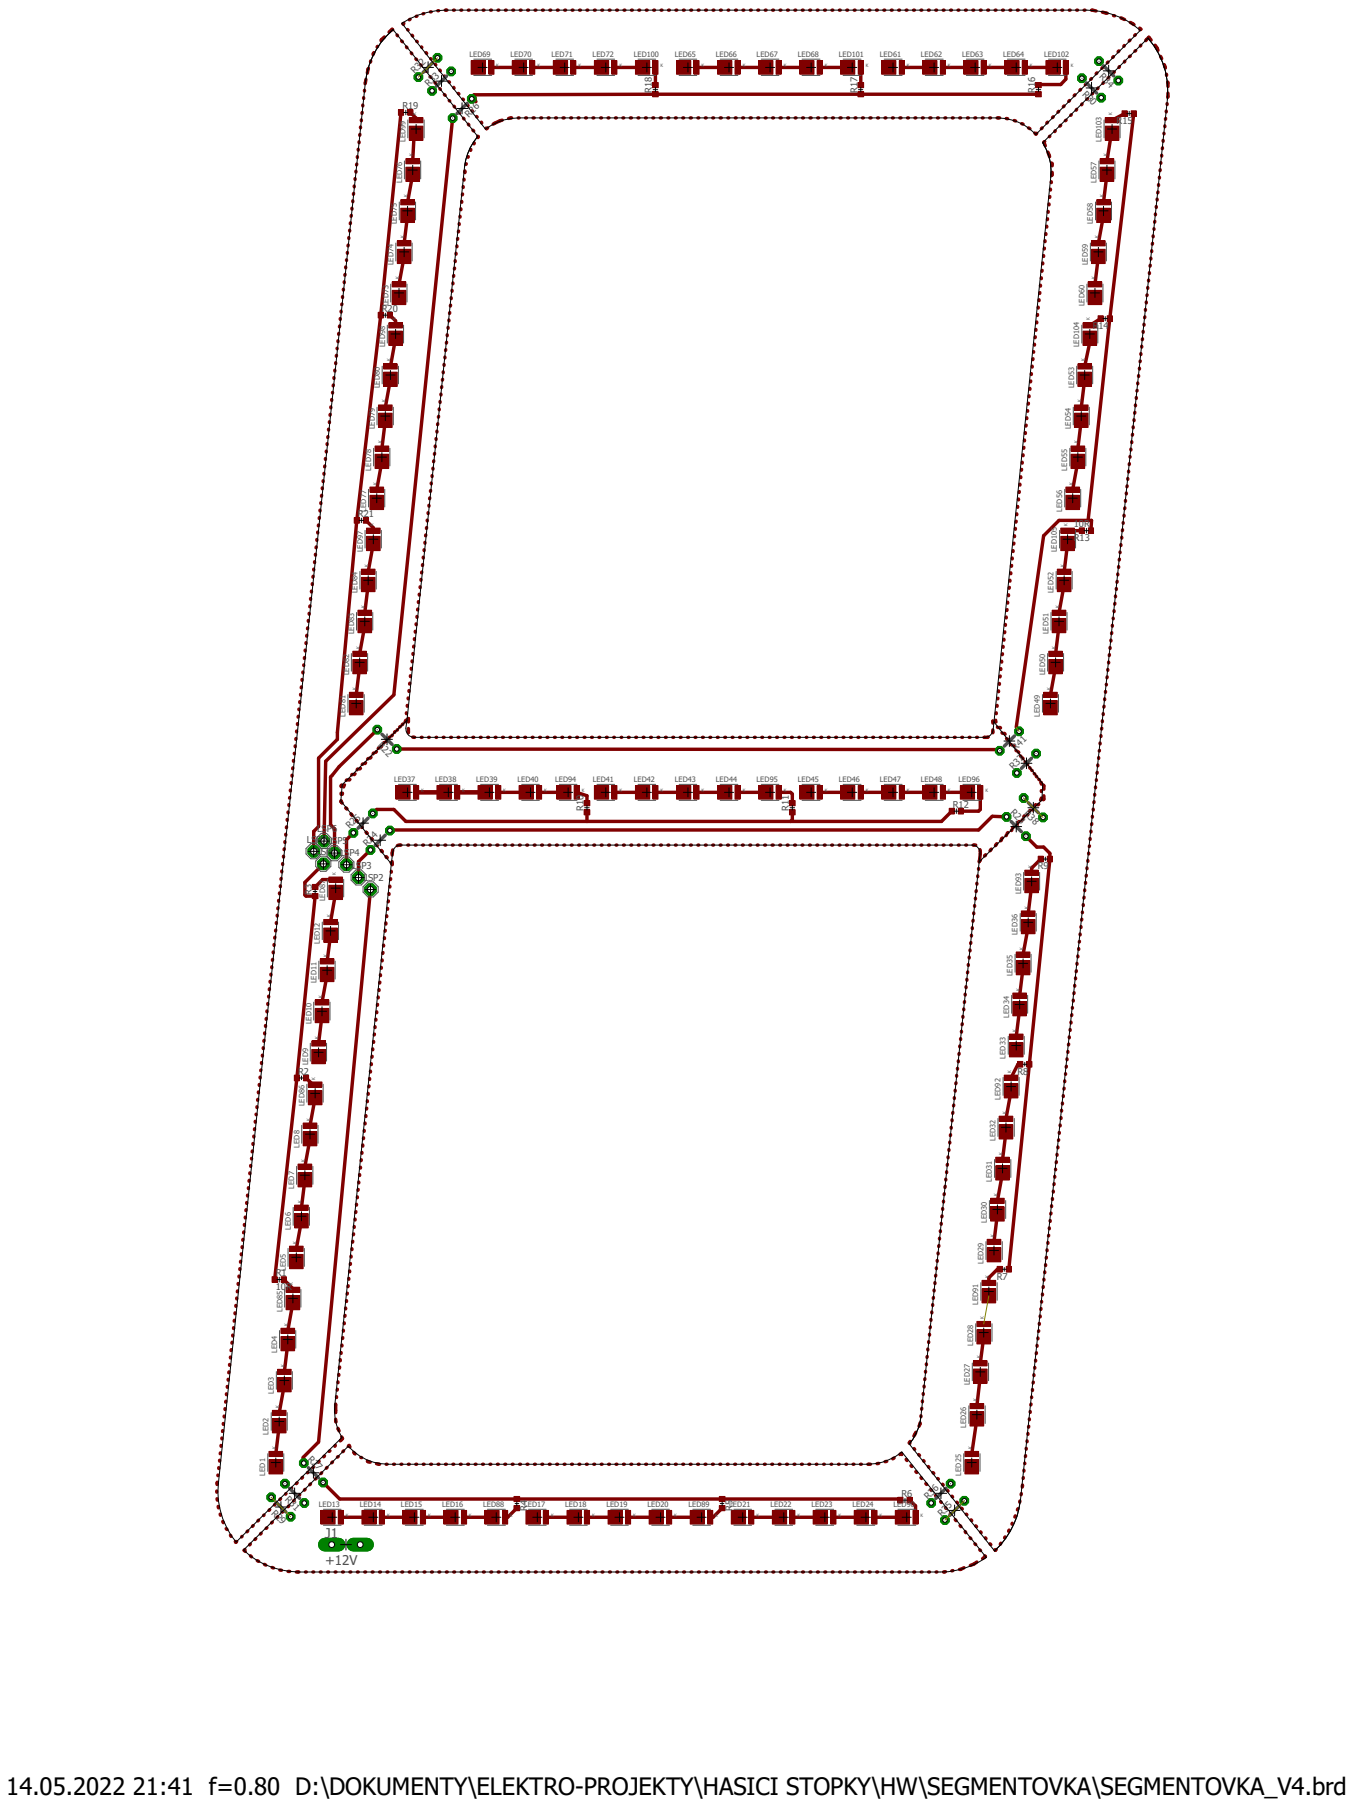
[picture p32: page 1]

14.05.2022 21:41 f=0.80 D:\DOKUMENTY\ELEKTRO-PROJEKTY\HASICI STOPKY\HW\SEGMENTOVKA\SEGMENTOVKA_V4.brd
