JanDrska/FIRESPORT-WATCH/HW/Eagle PCBs/CONTROL_PANEL/CTRL_PANEL_SCH.pdf

# +5V +⁵V

A

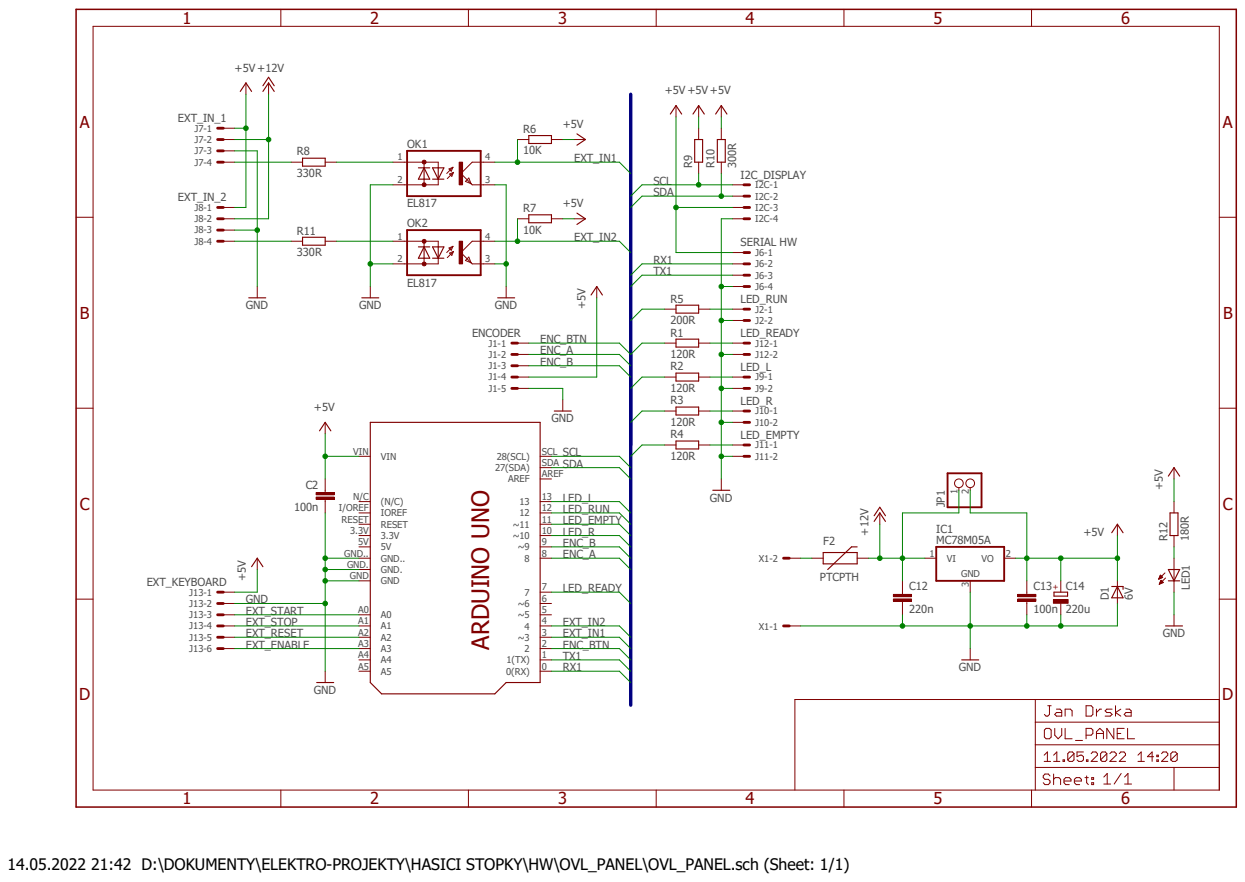
[picture p33: page 1]

14.05.2022 21:42 D:\DOKUMENTY\ELEKTRO-PROJEKTY\HASICI STOPKY\HW\OVL_PANEL\OVL_PANEL.sch (Sheet: 1/1)
