JanDrska/FIRESPORT-WATCH/HW/Eagle PCBs/I2C_MODULE/I2C_BOT_TOP.pdf

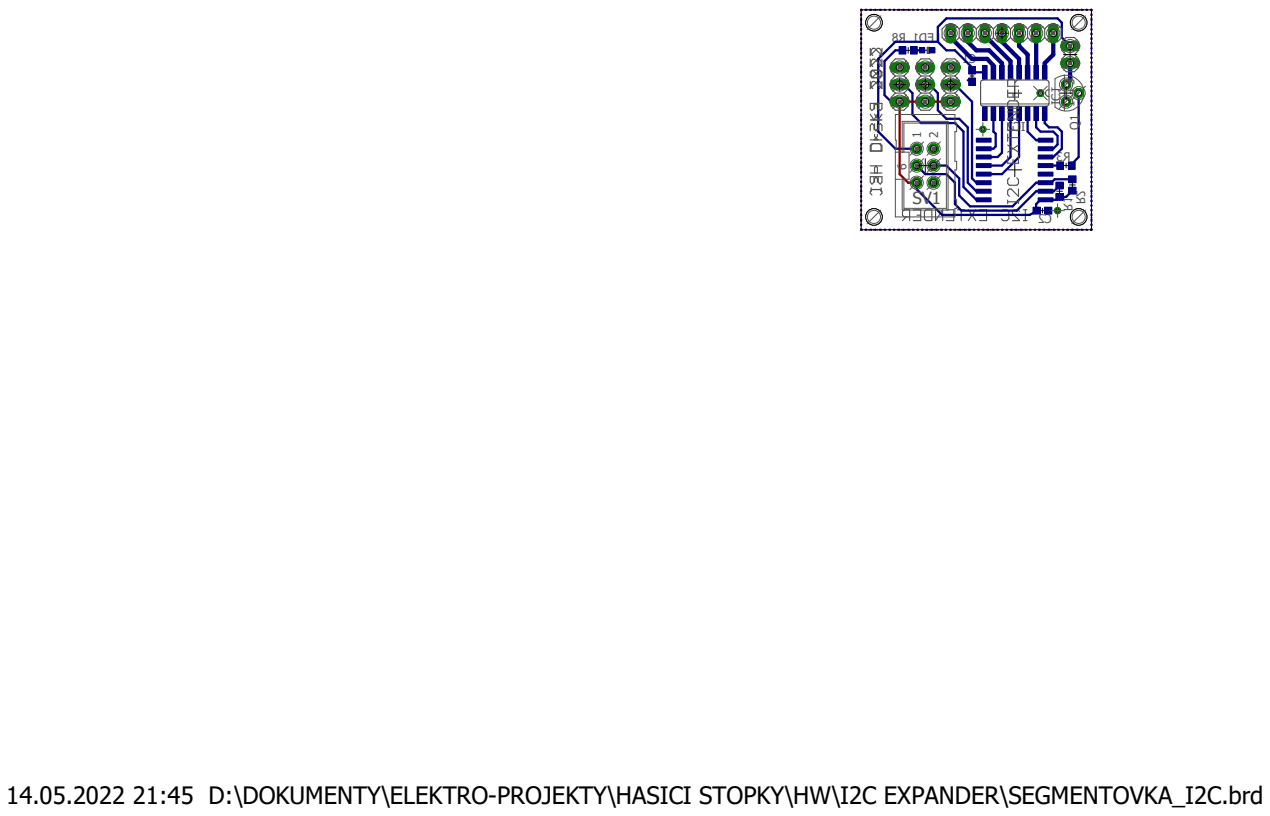
[picture p34: page 1]

14.05.2022 21:45 D:\DOKUMENTY\ELEKTRO-PROJEKTY\HASICI STOPKY\HW\I2C EXPANDER\SEGMENTOVKA_I2C.brd
