JanDrska/FIRESPORT-WATCH/HW/Eagle PCBs/I2C_MODULE/I2C_SCH.pdf

A

A

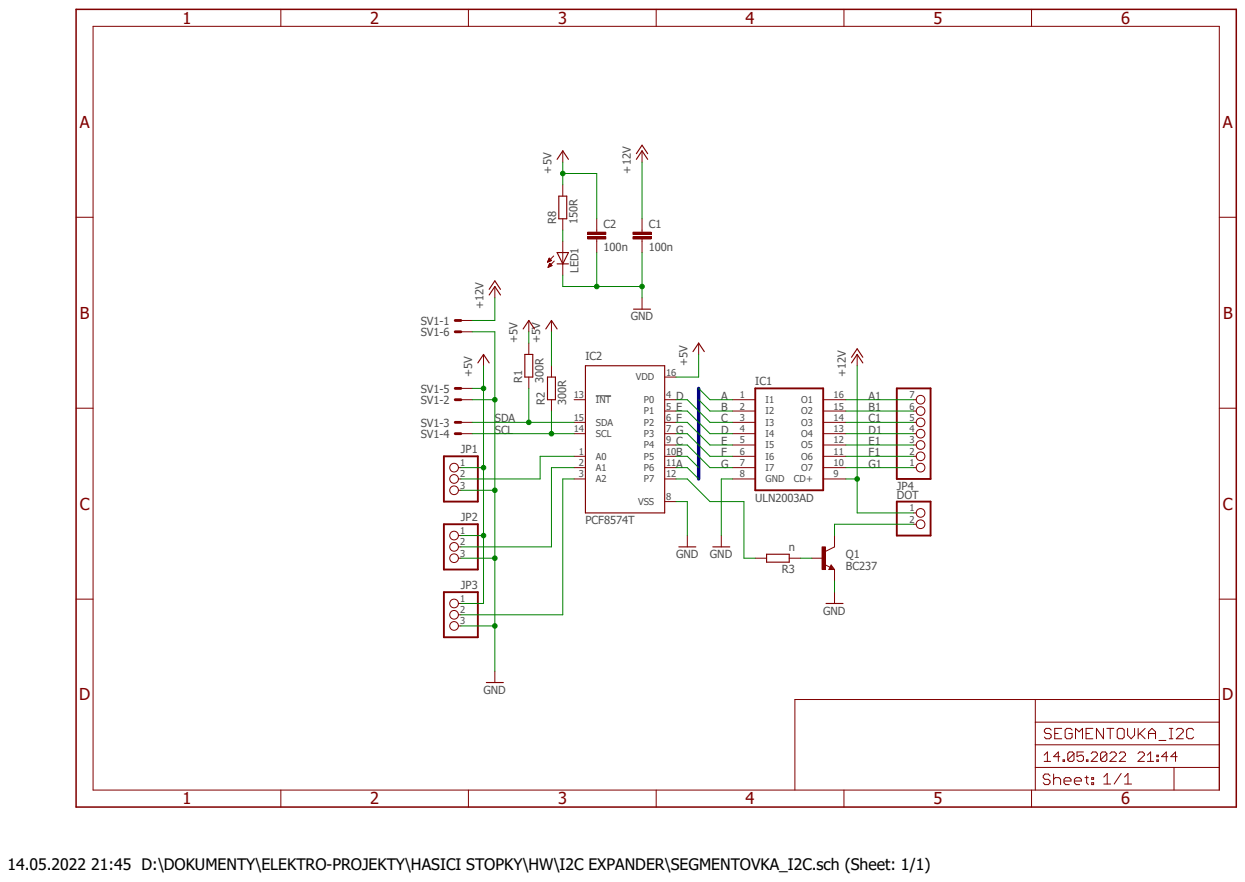
[picture p35: page 1]

14.05.2022 21:45 D:\DOKUMENTY\ELEKTRO-PROJEKTY\HASICI STOPKY\HW\I2C EXPANDER\SEGMENTOVKA_I2C.sch (Sheet: 1/1)
