JanDrska/FIRESPORT-WATCH/HW/Eagle PCBs/TARGETS/TARGET_BOT.pdf

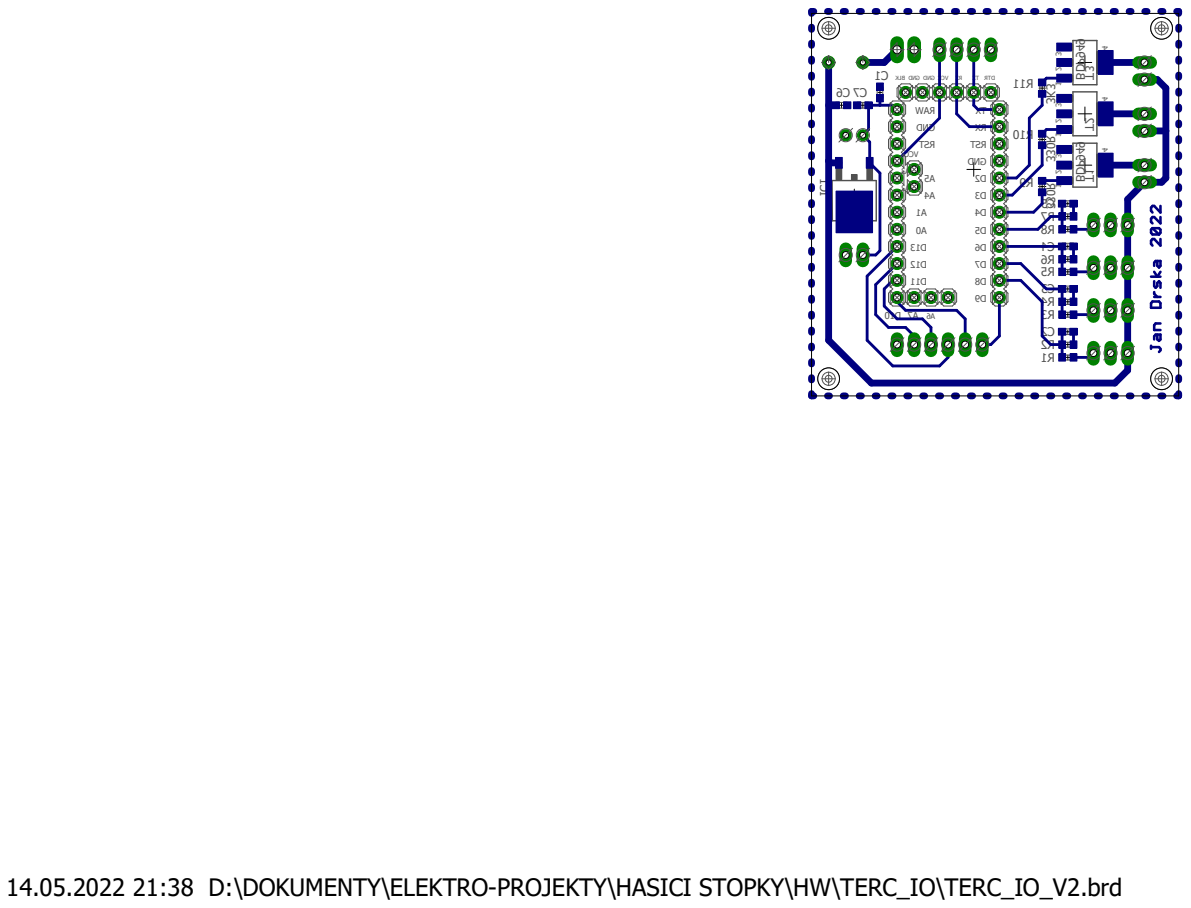
[picture p36: page 1]
14.05.2022 21:38 D:\DOKUMENTY\ELEKTRO-PROJEKTY\HASICI STOPKY\HW\TERC_IO\TERC_IO_V2.brd BDP949 BDP949 330R ³³⁰R ³K3 R1R2R3R4R5R6R7R8; RST GND
