JanDrska/FIRESPORT-WATCH/HW/Eagle PCBs/7SEGMENT/7SEGMENT_SCH.pdf

A

A

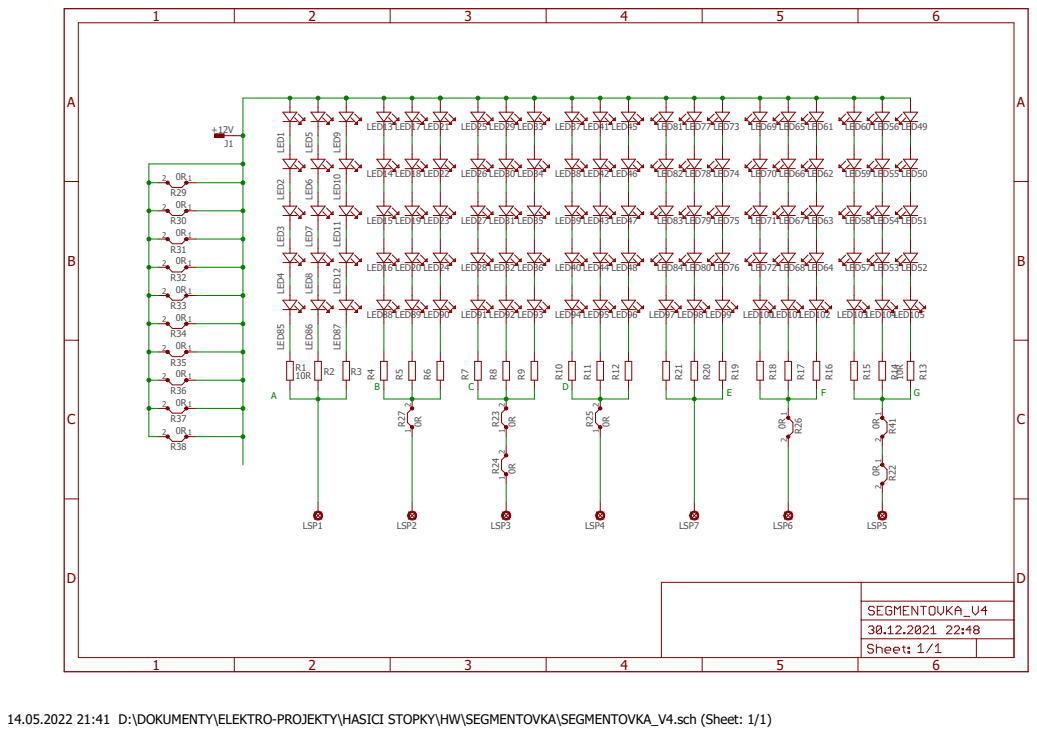
[picture p37: page 1]

14.05.2022 21:41 D:\DOKUMENTY\ELEKTRO-PROJEKTY\HASICI STOPKY\HW\SEGMENTOVKA\SEGMENTOVKA_V4.sch (Sheet: 1/1)
