JanDrska/FIRESPORT-WATCH/HW/Eagle PCBs/CONTROL_PANEL/CTRL_PANEL_BOT_TOP.pdf

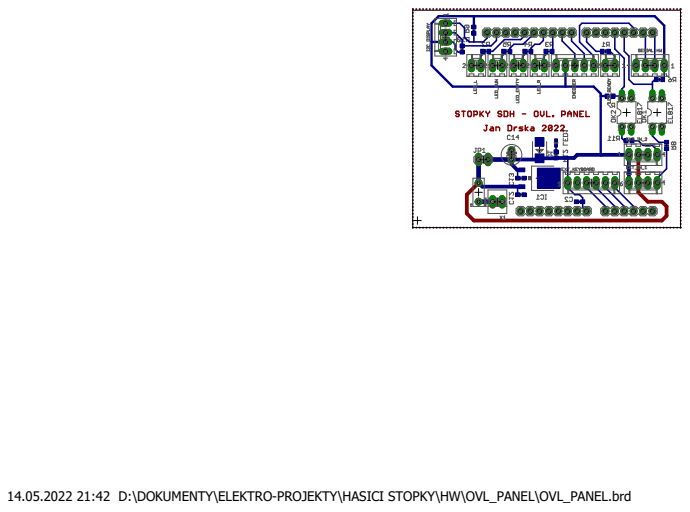
[picture p38: page 1]

14.05.2022 21:42 D:\DOKUMENTY\ELEKTRO-PROJEKTY\HASICI STOPKY\HW\OVL_PANEL\OVL_PANEL.brd
