JanDrska/FIRESPORT-WATCH/HW/Eagle PCBs/MAIN UNIT/MAIN_UNIT_BOT.pdf

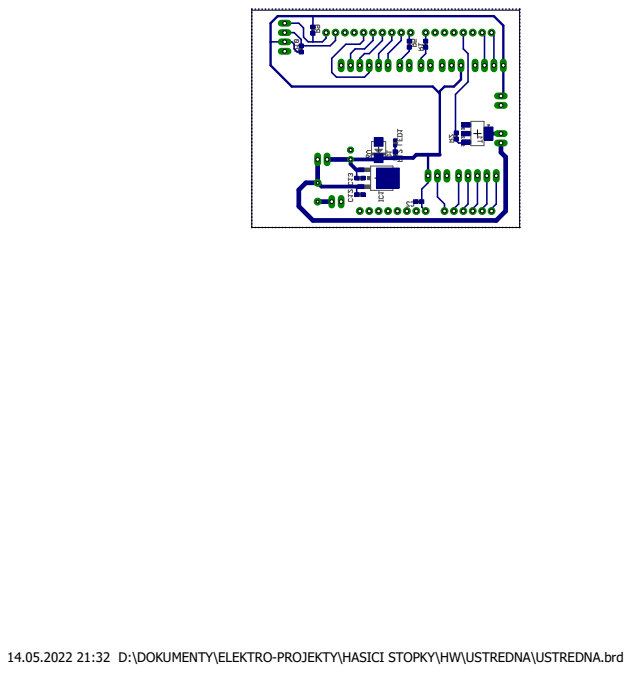
[picture p39: page 1]

14.05.2022 21:32 D:\DOKUMENTY\ELEKTRO-PROJEKTY\HASICI STOPKY\HW\USTREDNA\USTREDNA.brd
