JanDrska/FIRESPORT-WATCH/HW/Eagle PCBs/MAIN UNIT/MAIN_UNIT_SCH.pdf

A

A

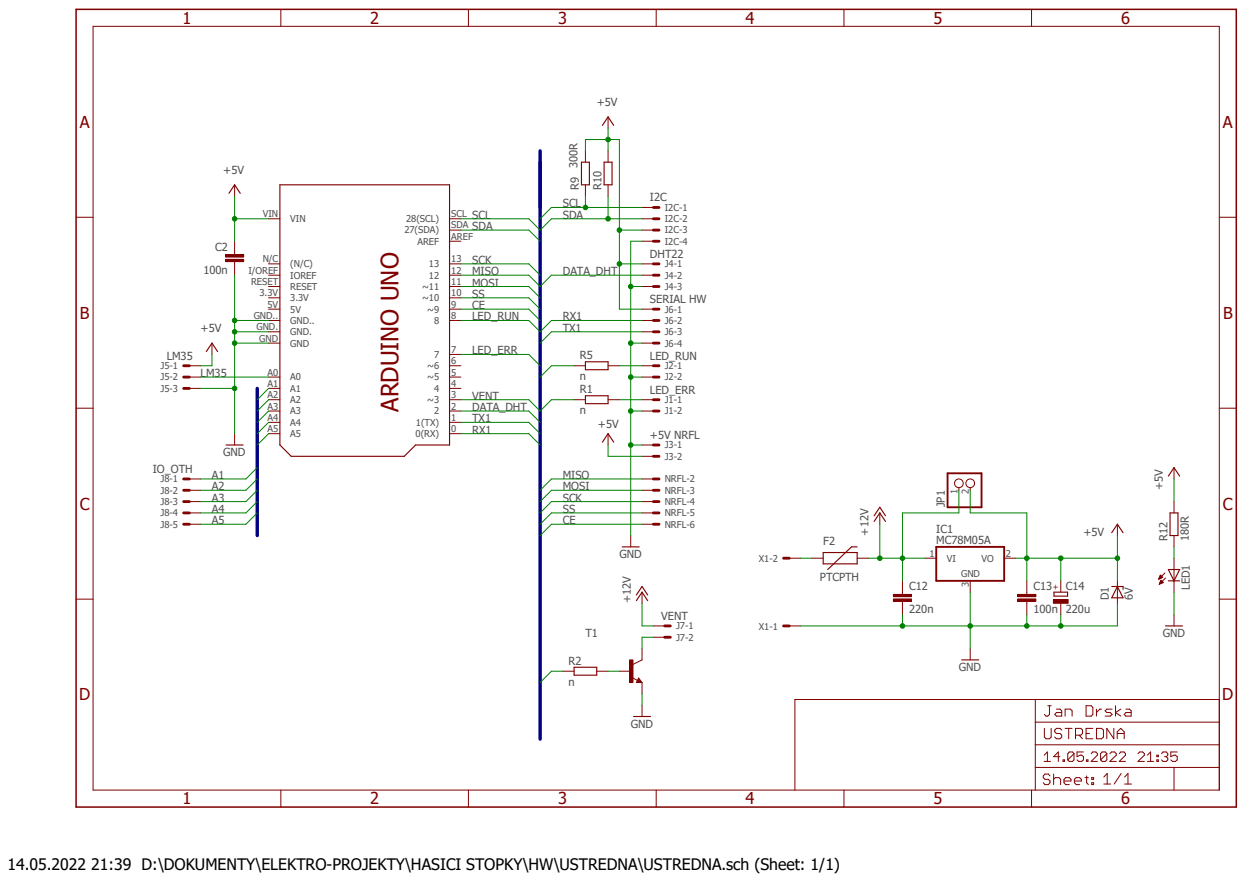
[picture p40: page 1]

14.05.2022 21:39 D:\DOKUMENTY\ELEKTRO-PROJEKTY\HASICI STOPKY\HW\USTREDNA\USTREDNA.sch (Sheet: 1/1)
