JanDrska/FIRESPORT-WATCH/HW/Eagle PCBs/MAIN UNIT/MAIN_UNIT_TOP.pdf

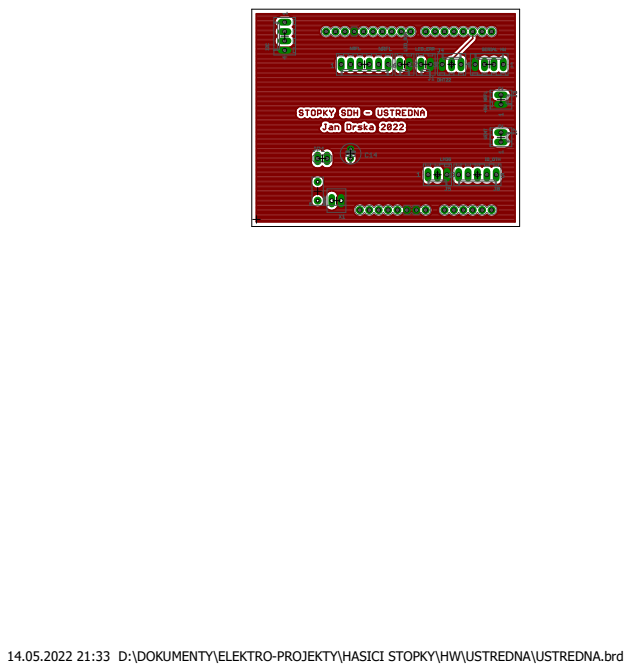
[picture p41: page 1]

14.05.2022 21:33 D:\DOKUMENTY\ELEKTRO-PROJEKTY\HASICI STOPKY\HW\USTREDNA\USTREDNA.brd
