JanDrska/FIRESPORT-WATCH/HW/Eagle PCBs/TARGETS/TARGET_SCH.pdf

D2 | D2 D3 | D3 D4 | D4 D5 | D5 D6 | D6 D7 | D7 D8 | D8 D9 | D9
VCC VCC*2 | A7 A7 | A6 A6 | A5 A5 | A4 A4 | A3 A3 | A2 A2 | A1 A1 | A0 A0 | D13 D13 | D12 D12 | D11 D11 | D10 D10

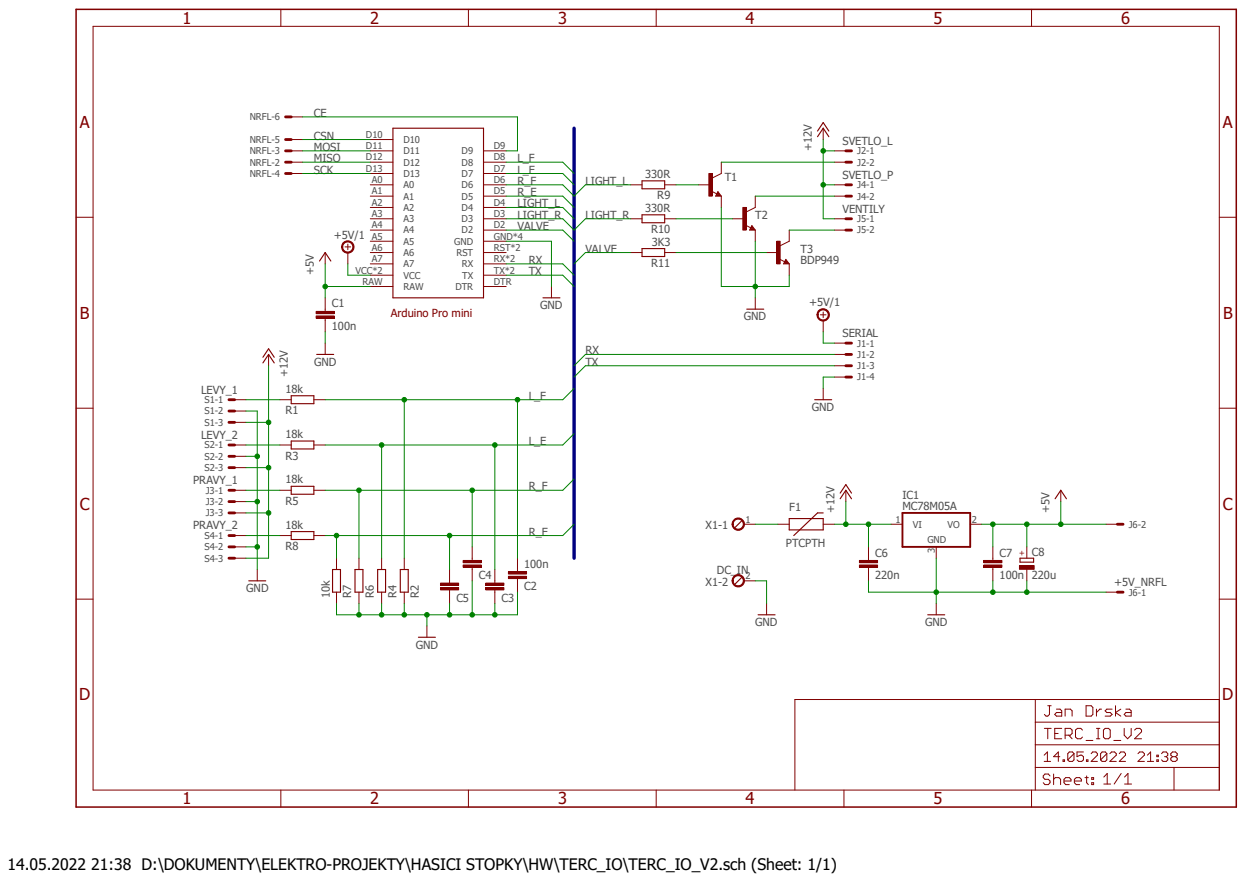
[picture p42: page 1]

14.05.2022 21:38 D:\DOKUMENTY\ELEKTRO-PROJEKTY\HASICI STOPKY\HW\TERC_IO\TERC_IO_V2.sch (Sheet: 1/1)
