JanDrska/FIRESPORT-WATCH/HW/Eagle PCBs/CONTROL_PANEL/CTRL_PANEL.brd

## EAGLE design HW/Eagle PCBs/CONTROL_PANEL/CTRL_PANEL.brd (2022-05-29)

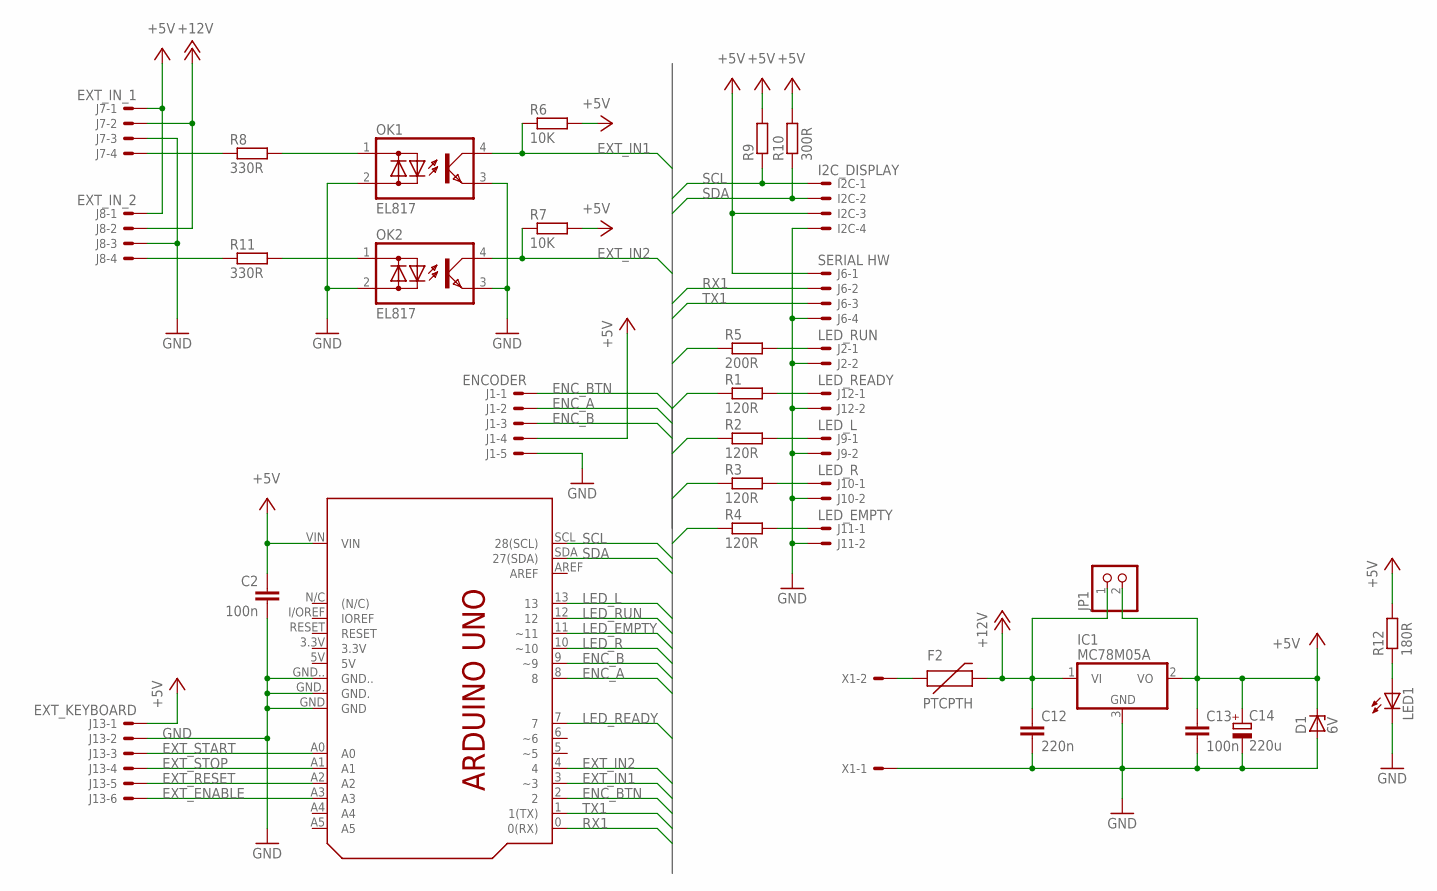
[picture p43: schematic CTRL_PANEL.sch]

Parts:
C2, C13: 100n; C0603
C12: 220n; C0603
C14: 220u; E2,5-6E
D1: 6V; SMB
F2: PTCPTH; PTC
I2C: I2C_DISPLAY; 6410-04
IC1: MC78M05A; TO252
J1: ENCODER; 6410-05
J2: LED_RUN; 6410-02
J6: SERIAL HW; 6410-04
J7: EXT_IN_1; 6410-04
J8: EXT_IN_2; 6410-04
J9: LED_L; 6410-02
J10: LED_R; 6410-02
J11: LED_EMPTY; 6410-02
J12: LED_READY; 6410-02
J13: EXT_KEYBOARD; 6410-06
JP1: PINHD-1X2; 1X02
LED1: LEDCHIP-LED0603; CHIP-LED0603
OK1, OK2: EL817; DIL04
PCB1: ARDUINO_UNO
R1, R2, R3, R4: 120R; R0603
R5: 200R; R0603
R6, R7: 10K; R0603
R8, R11: 330R; R0603
R9: R-EU_R0603; R0603
R10: 300R; R0603
R12: 180R; R0603
X1: 22-23-2021

Connections:
+5V: C2.1, C13.1, C14.+, D1.C, I2C.3, IC1.2 (VO), J1.4, J6.1, J7.1, J8.1, J13.1, JP1.2, PCB1.VIN, R6.2, R7.2, R9.2, R10.2, R12.2
+12V: C12.1, F2.P$2 (2), IC1.1 (VI), J7.2, J8.2, JP1.1
ENC_A: J1.2, PCB1.8
ENC_B: J1.3, PCB1.9 (~9)
ENC_BTN: J1.1, PCB1.2
EXT_ENABLE: J13.6, PCB1.A3
EXT_IN1: OK1.4 (C), PCB1.3 (~3), R6.1
EXT_IN2: OK2.4 (C), PCB1.4, R7.1
EXT_RESET: J13.5, PCB1.A2
EXT_START: J13.3, PCB1.A0
EXT_STOP: J13.4, PCB1.A1
GND: C2.2, C12.2, C13.2, C14.-, D1.A, I2C.4, IC1.3 (GND), J1.5, J2.2, J6.4, J7.3, J8.3, J9.2, J10.2, J11.2, J12.2, J13.2, LED1.C, OK1.2 (AC2), OK1.3 (E), OK2.2 (AC2), OK2.3 (E), PCB1.GND, PCB1.GND., PCB1.GND.., X1.1
LED_EMPTY: PCB1.11 (~11), R4.1
LED_L: PCB1.13, R2.1
LED_R: PCB1.10 (~10), R3.1
LED_READY: PCB1.7, R1.1
LED_RUN: PCB1.12, R5.1
unnamed: J12.1, R1.2
unnamed: J2.1, R5.2
unnamed: J9.1, R2.2
unnamed: J10.1, R3.2
unnamed: J11.1, R4.2
unnamed: F2.P$1 (1), X1.2
unnamed: J7.4, R8.1
unnamed: J8.4, R11.1
unnamed: LED1.A, R12.1
unnamed: OK2.1 (AC1), R11.2
unnamed: OK1.1 (AC1), R8.2
RX1: J6.2, PCB1.0 (0(RX))
SCL: I2C.1, PCB1.SCL (28(SCL)), R9.1
SDA: I2C.2, PCB1.SDA (27(SDA)), R10.1
TX1: J6.3, PCB1.1 (1(TX))

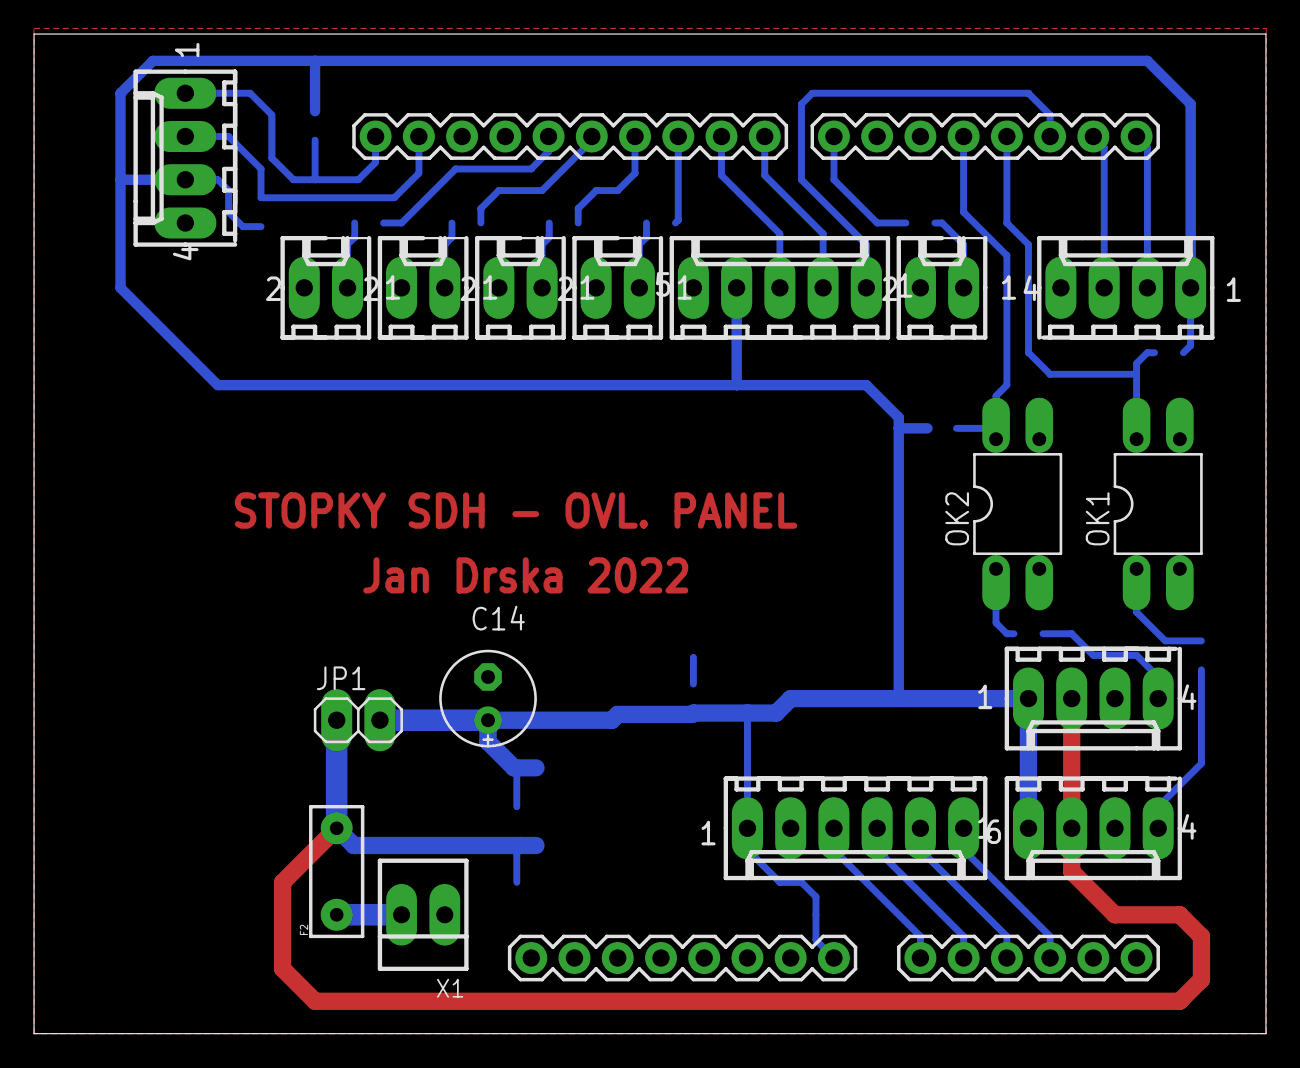
[picture p44: board CTRL_PANEL.brd from above]

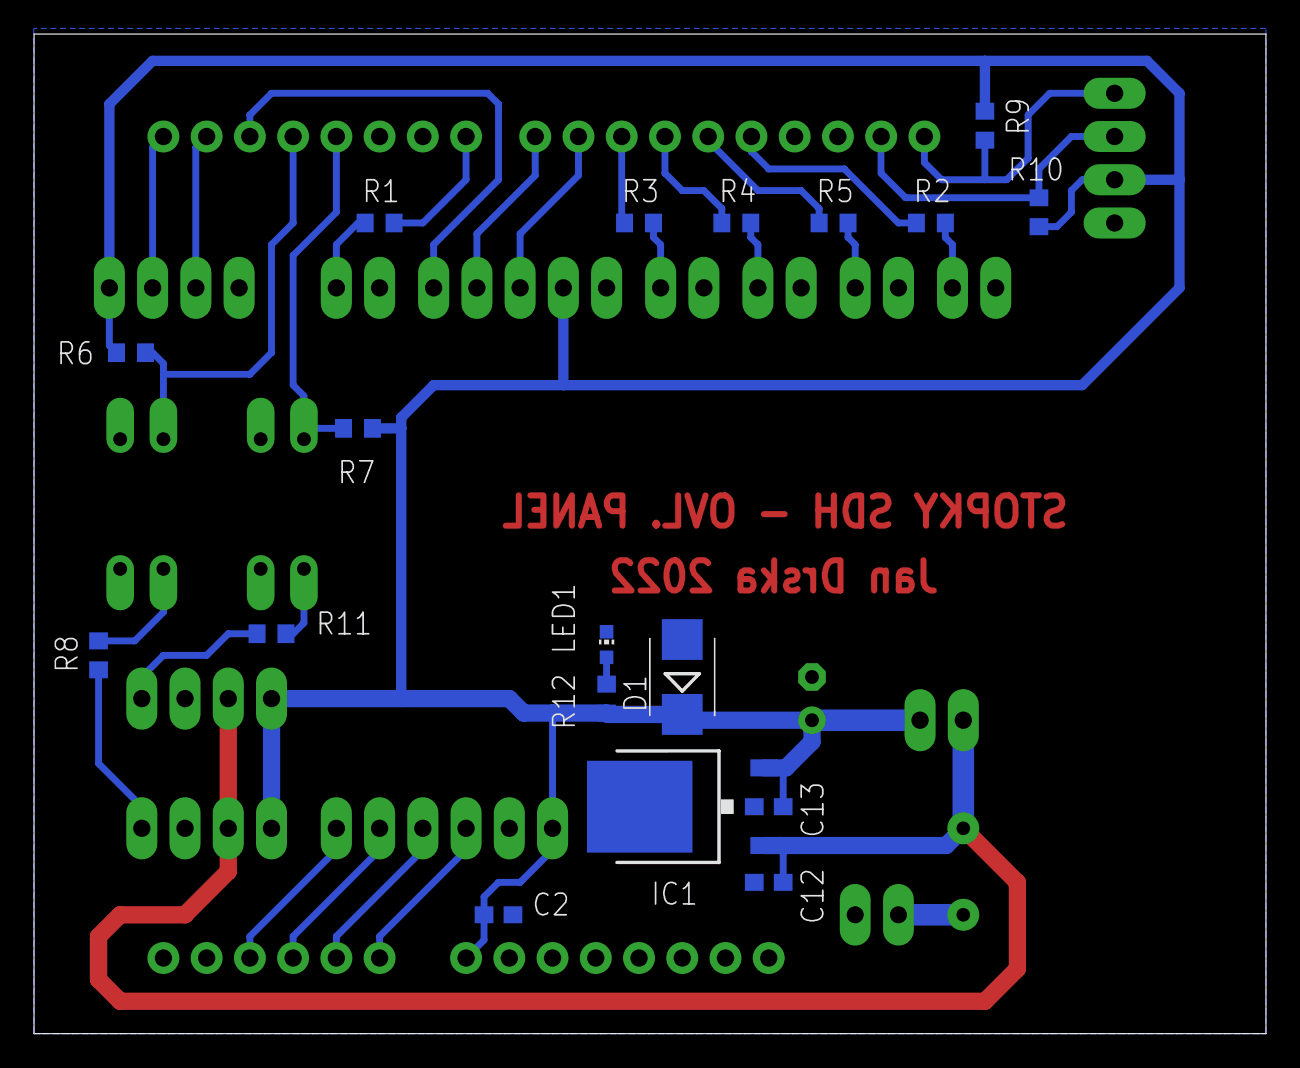
[picture p45: board CTRL_PANEL.brd from below]

Board: 2 copper layers, 72.4 x 58.7 mm, 36 parts (18 on the bottom side), 32 nets.
