JanDrska/FIRESPORT-WATCH/HW/Eagle PCBs/MAIN UNIT/MAIN_UNIT.brd

## EAGLE design HW/Eagle PCBs/MAIN UNIT/MAIN_UNIT.brd (2022-05-29)

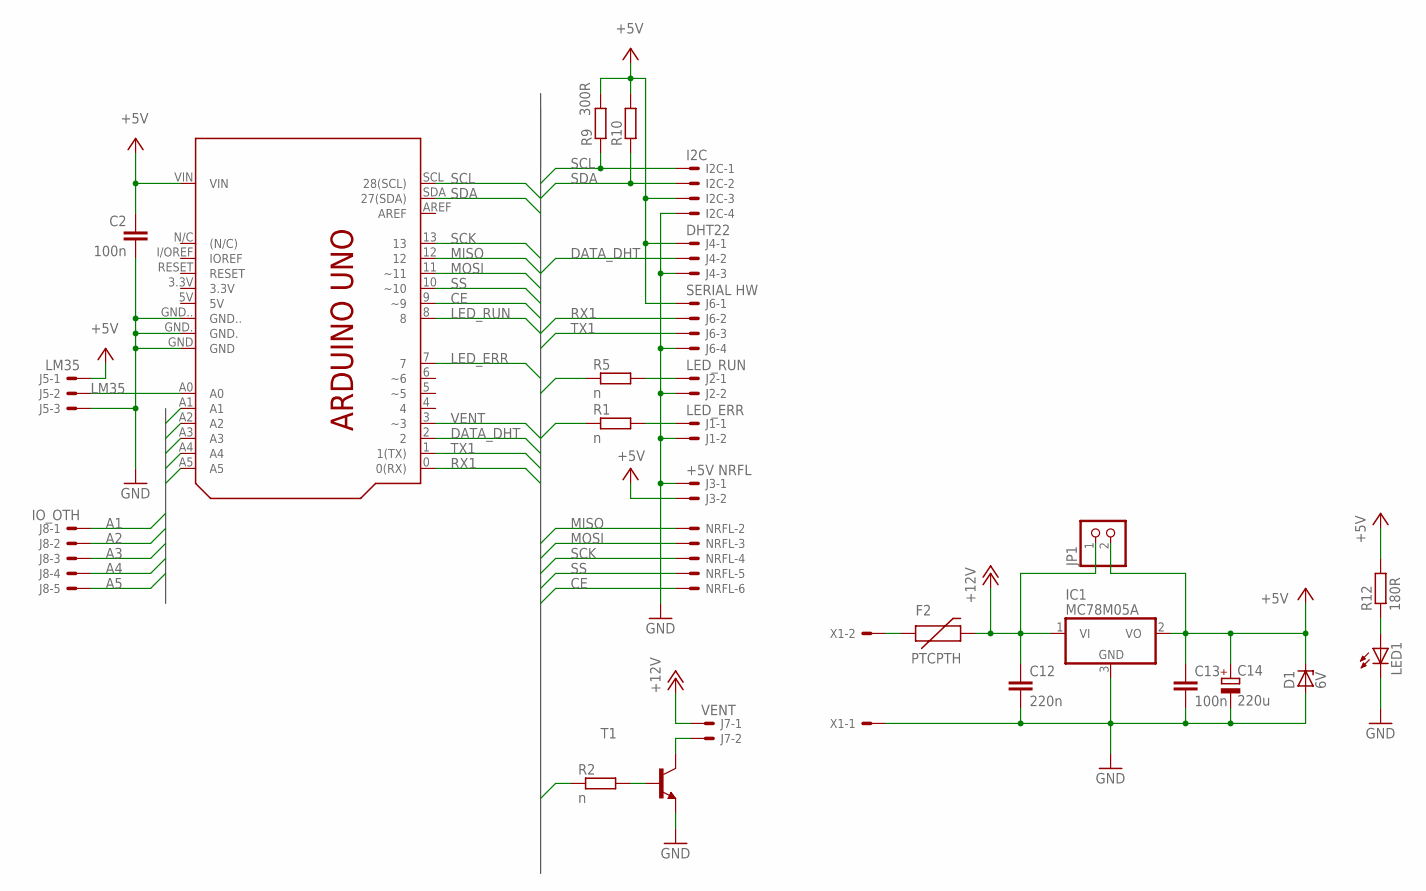
[picture p46: schematic MAIN_UNIT.sch]

Parts:
C2, C13: 100n; C0603
C12: 220n; C0603
C14: 220u; E2,5-6E
D1: 6V; SMB
F2: PTCPTH; PTC
I2C: I2C; 6410-04
IC1: MC78M05A; TO252
J1: LED_ERR; 6410-02
J2: LED_RUN; 6410-02
J3: +5V NRFL; 6410-02
J4: DHT22; 6410-03
J5: LM35; 6410-03
J6: SERIAL HW; 6410-04
J7: VENT; 6410-02
J8: IO_OTH; 6410-05
JP1: PINHD-1X2; 1X02
LED1: LEDCHIP-LED0603; CHIP-LED0603
NRFL: NRFL; 6410-06
PCB1: ARDUINO_UNO
R1, R2, R5: n; R0603
R9: R-EU_R0603; R0603
R10: 300R; R0603
R12: 180R; R0603
T1: -NPN-SOT223; SOT223
X1: 22-23-2021

Connections:
+5V: C2.1, C13.1, C14.+, D1.C, I2C.3, IC1.2 (VO), J3.2, J4.1, J5.1, J6.1, JP1.2, PCB1.VIN, R9.2, R10.2, R12.2
+12V: C12.1, F2.P$2 (2), IC1.1 (VI), J7.1, JP1.1
A1: J8.1, PCB1.A1
A2: J8.2, PCB1.A2
A3: J8.3, PCB1.A3
A4: J8.4, PCB1.A4
A5: J8.5, PCB1.A5
CE: NRFL.6, PCB1.9 (~9)
DATA_DHT: J4.2, PCB1.2
GND: C2.2, C12.2, C13.2, C14.-, D1.A, I2C.4, IC1.3 (GND), J1.2, J2.2, J3.1, J4.3, J5.3, J6.4, LED1.C, PCB1.GND, PCB1.GND., PCB1.GND.., T1.3 (E), X1.1
LED_ERR: PCB1.7, R1.1
LED_RUN: PCB1.8, R5.1
LM35: J5.2, PCB1.A0
MISO: NRFL.2, PCB1.12
MOSI: NRFL.3, PCB1.11 (~11)
unnamed: J1.1, R1.2
unnamed: R2.2, T1.1 (B)
unnamed: J2.1, R5.2
unnamed: J7.2, T1.4 (C)
unnamed: F2.P$1 (1), X1.2
unnamed: LED1.A, R12.1
RX1: J6.2, PCB1.0 (0(RX))
SCK: NRFL.4, PCB1.13
SCL: I2C.1, PCB1.SCL (28(SCL)), R9.1
SDA: I2C.2, PCB1.SDA (27(SDA)), R10.1
SS: NRFL.5, PCB1.10 (~10)
TX1: J6.3, PCB1.1 (1(TX))
VENT: PCB1.3 (~3), R2.1

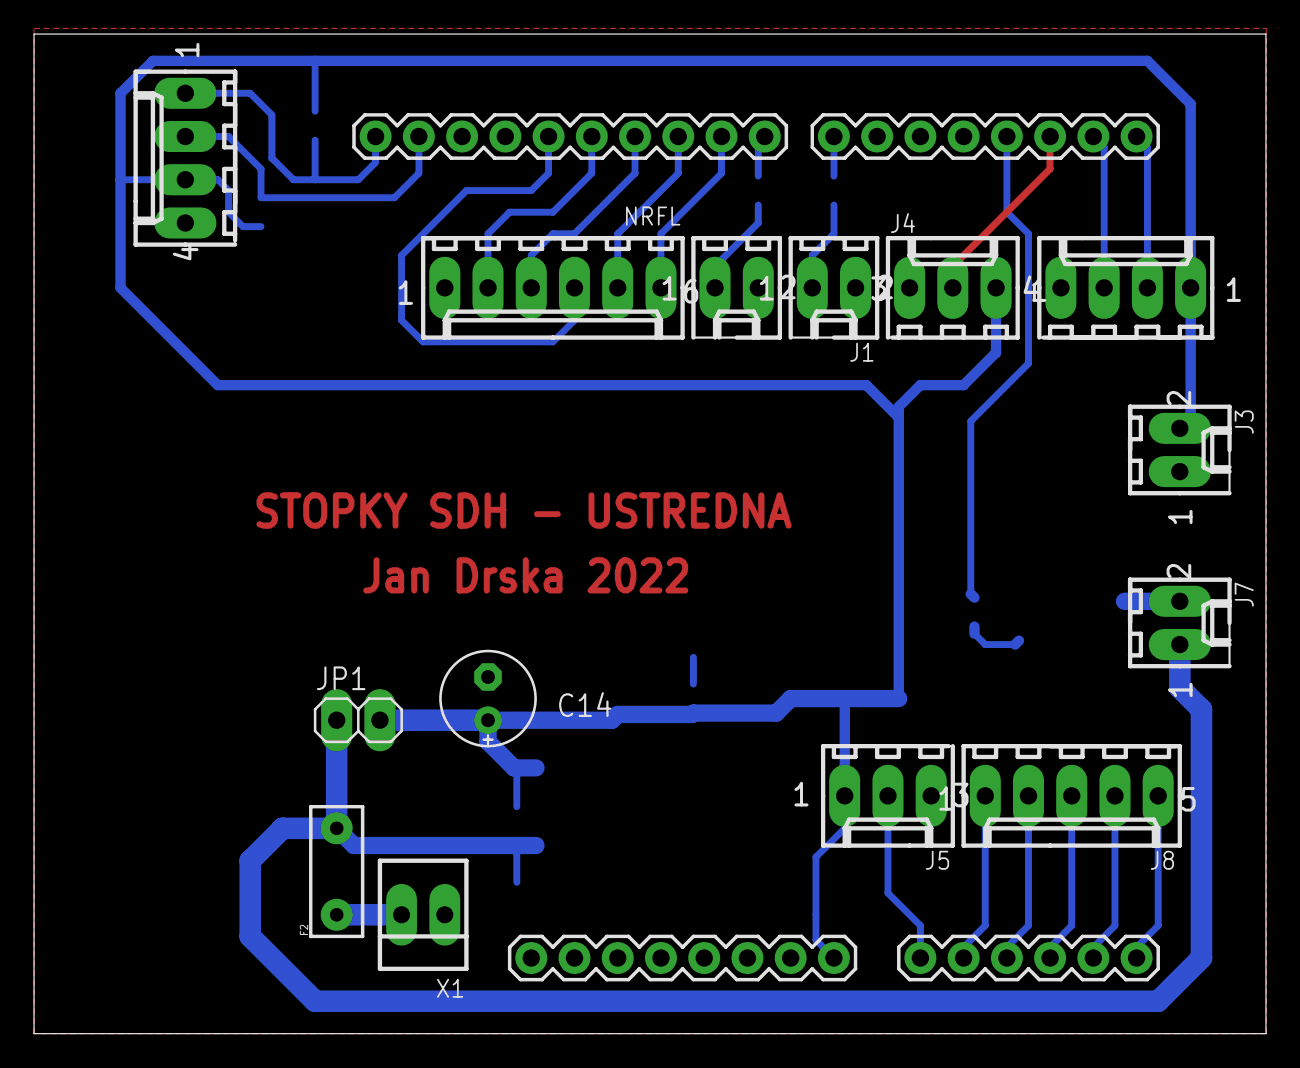
[picture p47: board MAIN_UNIT.brd from above]

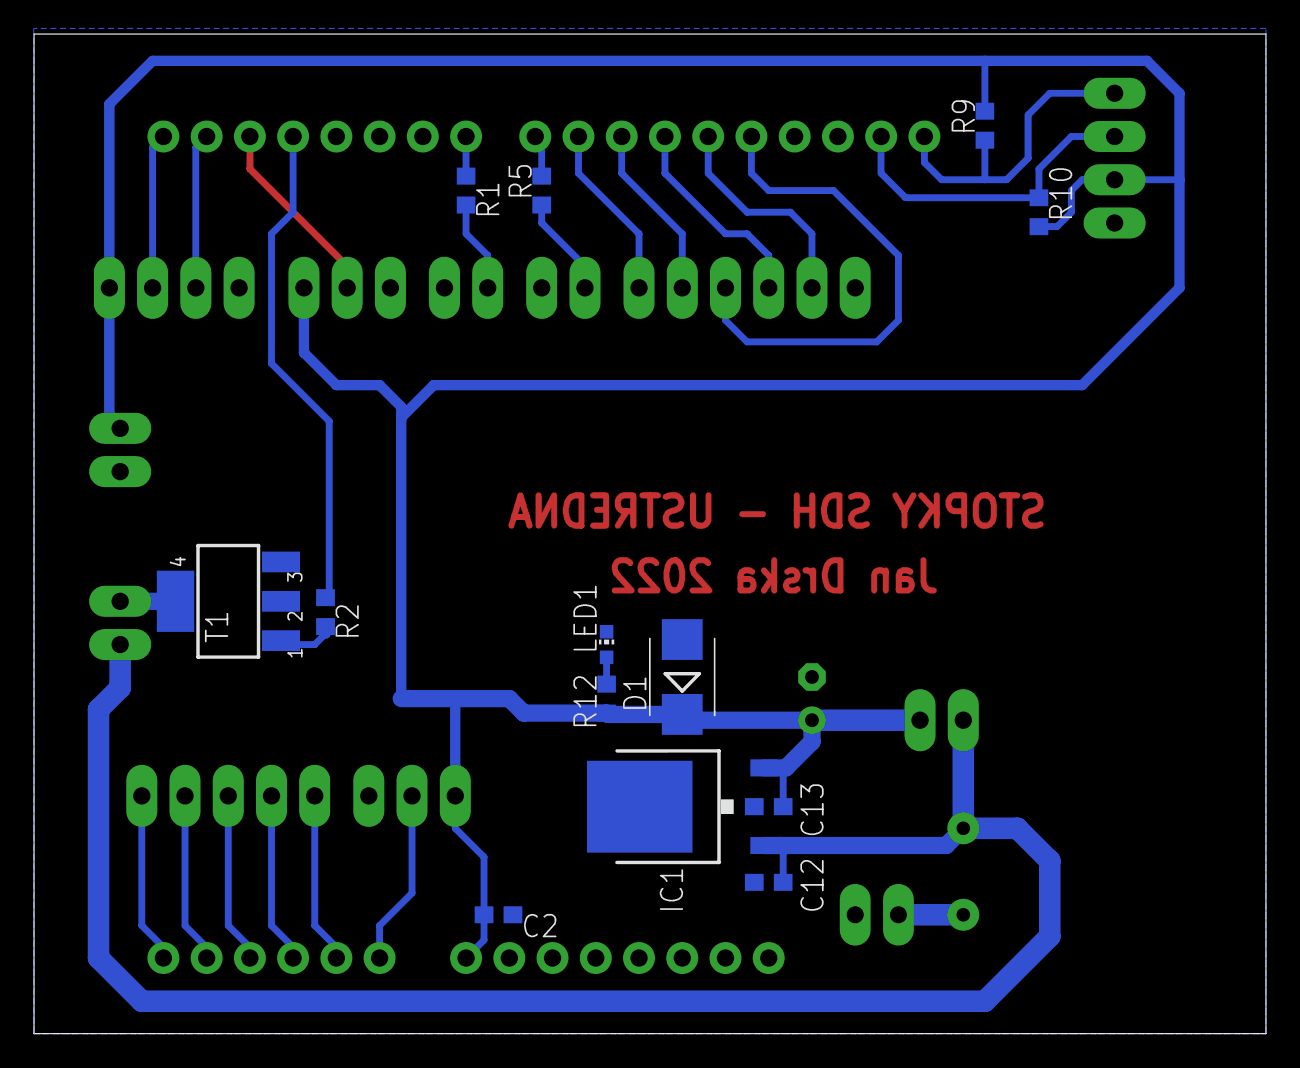
[picture p48: board MAIN_UNIT.brd from below]

Board: 2 copper layers, 72.4 x 58.7 mm, 28 parts (13 on the bottom side), 28 nets.
