JanDrska/FIRESPORT-WATCH/HW/Eagle PCBs/I2C_MODULE/7SEGMENT_I2C.brd

## EAGLE design HW/Eagle PCBs/I2C_MODULE/7SEGMENT_I2C.brd (2022-05-29)

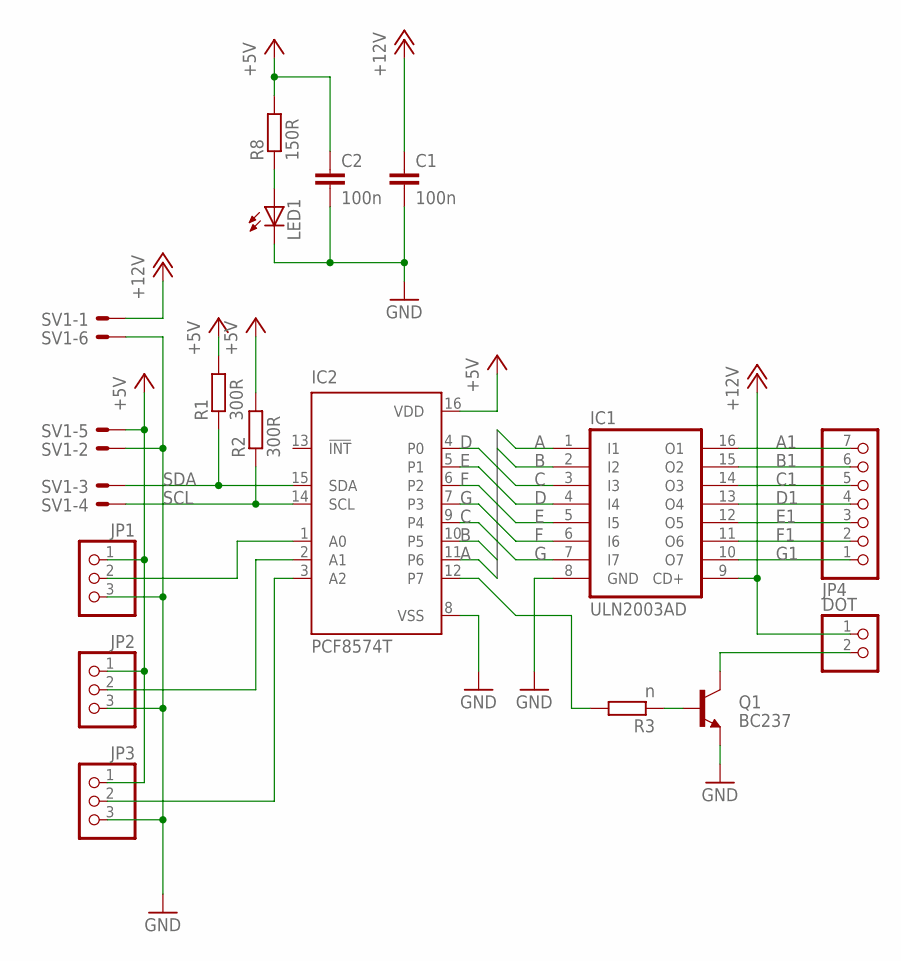
[picture p49: schematic 7SEGMENT_I2C.sch]

Parts:
C1, C2: 100n; C0603
DOT: PINHD-1X2; 1X02
IC1: ULN2003AD; SO16
IC2: PCF8574T; SO16W
JP1, JP2, JP3: PINHD-1X3; 1X03
JP4: PINHD-1X7; 1X07
LED1: LEDCHIP-LED0603; CHIP-LED0603
Q1: BC237; TO92
R1, R2: 300R; R0603
R3: n; R0603
R8: 150R; R0603
SV1: ML6E; ML6

Connections:
+5V: C2.1, IC2.16 (VDD), JP1.1, JP2.1, JP3.1, R1.2, R2.2, R8.2, SV1.5
+12V: C1.1, DOT.1, IC1.9 (CD+), SV1.1
A: IC1.1 (I1), IC2.11 (P6)
A1: IC1.16 (O1), JP4.7
B: IC1.2 (I2), IC2.10 (P5)
B1: IC1.15 (O2), JP4.6
C: IC1.3 (I3), IC2.9 (P4)
C1: IC1.14 (O3), JP4.5
D: IC1.4 (I4), IC2.4 (P0)
D1: IC1.13 (O4), JP4.4
E: IC1.5 (I5), IC2.5 (P1)
E1: IC1.12 (O5), JP4.3
F: IC1.6 (I6), IC2.6 (P2)
F1: IC1.11 (O6), JP4.2
G: IC1.7 (I7), IC2.7 (P3)
G1: IC1.10 (O7), JP4.1
GND: C1.2, C2.2, IC1.8 (GND), IC2.8 (VSS), JP1.3, JP2.3, JP3.3, LED1.C, Q1.1 (E), SV1.2, SV1.6
unnamed: DOT.2, Q1.3 (C)
unnamed: Q1.2 (B), R3.1
unnamed: IC2.12 (P7), R3.2
unnamed: IC2.1 (A0), JP1.2
unnamed: IC2.2 (A1), JP2.2
unnamed: IC2.3 (A2), JP3.2
unnamed: LED1.A, R8.1
SCL: IC2.14 (SCL), R2.1, SV1.4
SDA: IC2.15 (SDA), R1.1, SV1.3

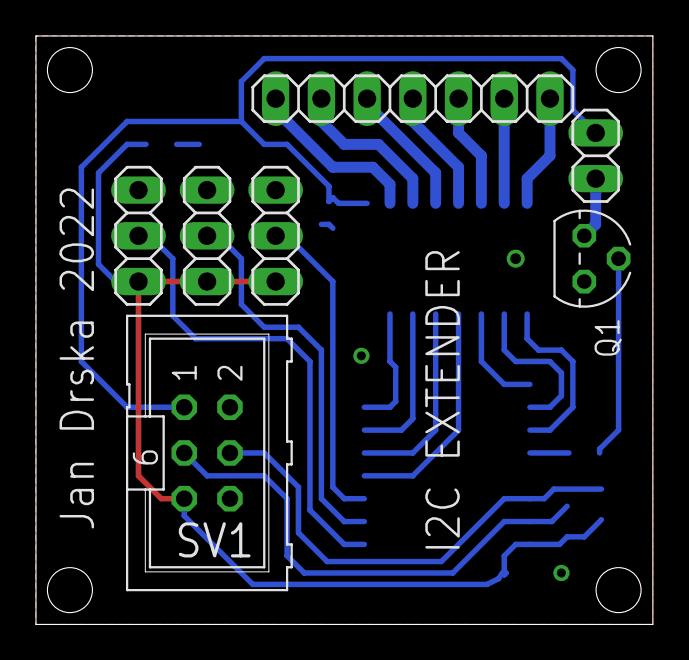
[picture p50: board 7SEGMENT_I2C.brd from above]

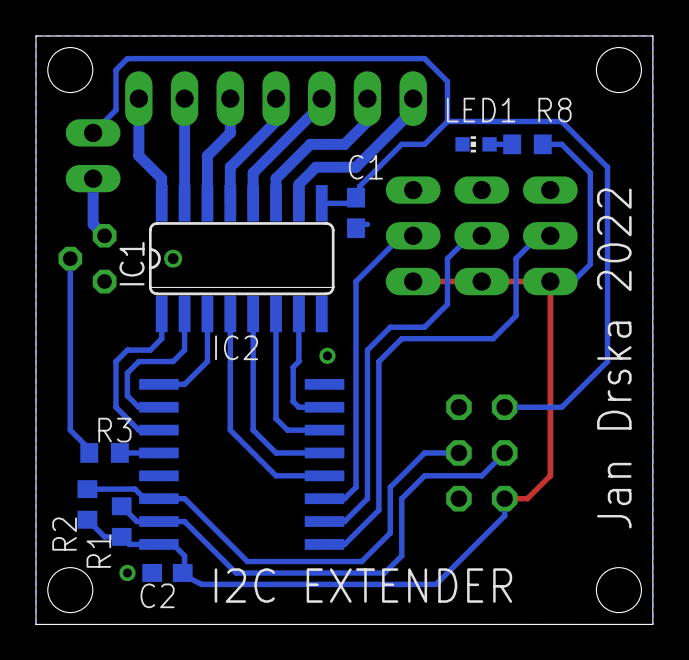
[picture p51: board 7SEGMENT_I2C.brd from below]

Board: 2 copper layers, 34.3 x 32.7 mm, 16 parts (9 on the bottom side), 26 nets.
