JanDrska/FIRESPORT-WATCH/HW/Eagle PCBs/TARGETS/TARGET.brd

## EAGLE design HW/Eagle PCBs/TARGETS/TARGET.brd (2022-05-29)

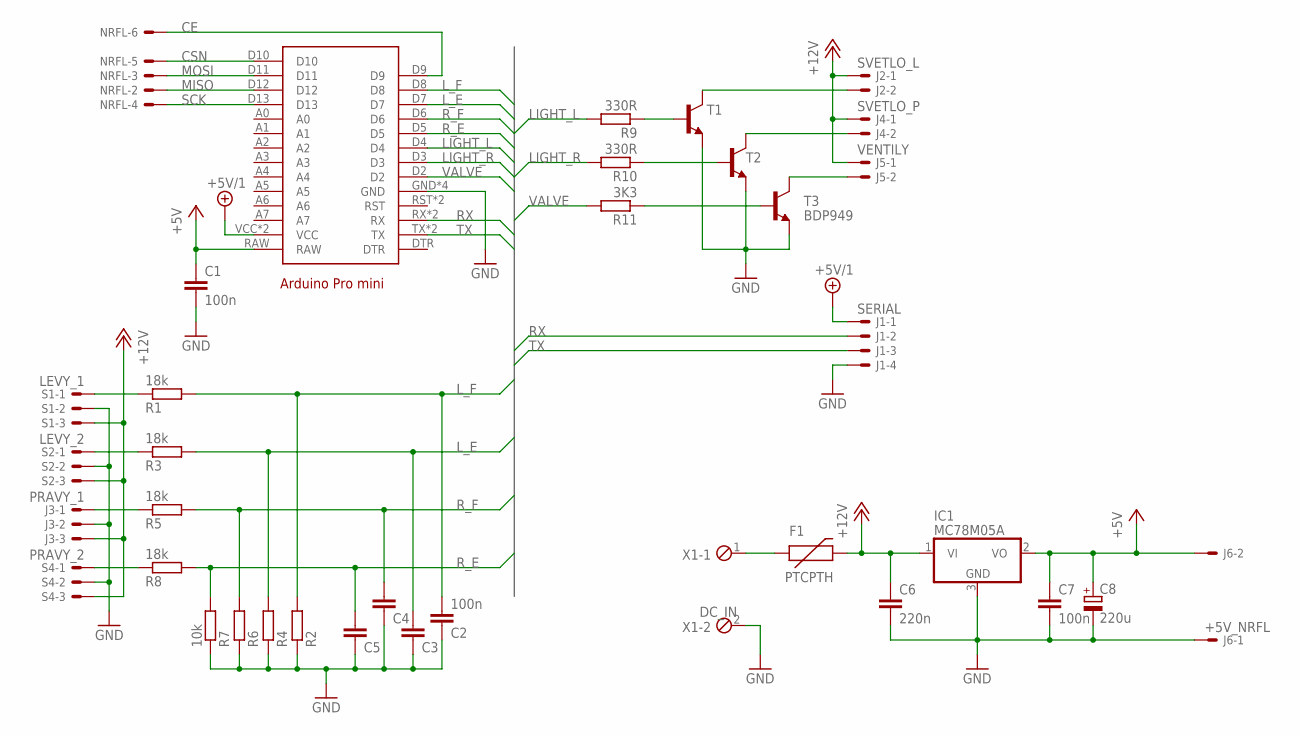
[picture p52: schematic TARGET.sch]

Parts:
ARDUINO1: ARDUINO_PRO_MINI
C1, C2, C7: 100n; C0603
C3, C4, C5: C-EUC0603; C0603
C6: 220n; C0603
C8: 220u; E2,5-6E
F1: PTCPTH; PTC
IC1: MC78M05A; TO252
J1: SERIAL; 6410-04
J2: SVETLO_L; 6410-02
J3: PRAVY_1; 6410-03
J4: SVETLO_P; 6410-02
J5: VENTILY; 6410-02
J6: +5V_NRFL; 6410-02
NRFL: NRFL; 6410-06
R1, R3, R5, R8: 18k; R0603
R2, R4, R6: R-EU_R0603; R0603
R7: 10k; R0603
R9, R10: 330R; R0603
R11: 3K3; R0603
S1: LEVY_1; 6410-03
S2: LEVY_2; 6410-03
S4: PRAVY_2; 6410-03
T1, T3: BDP949; SOT223
T2: -NPN-SOT223; SOT223
X1: DC_IN; 2POL254

Connections:
+5V: ARDUINO1.RAW, C1.1, C7.1, C8.+, IC1.2 (VO), J6.2
+5V/1: ARDUINO1.VCC, ARDUINO1.VCC@1 (VCC), J1.1
+12V: C6.1, F1.P$2 (2), IC1.1 (VI), J2.1, J3.3, J4.1, J5.1, S1.3, S2.3, S4.3
CE: ARDUINO1.D9, NRFL.6
CSN: ARDUINO1.D10, NRFL.5
GND: ARDUINO1.GND, ARDUINO1.GND@1 (GND), ARDUINO1.GND@2 (GND), ARDUINO1.GND@3 (GND), C1.2, C2.1, C3.1, C4.1, C5.1, C6.2, C7.2, C8.-, IC1.3 (GND), J1.4, J3.2, J6.1, R2.1, R4.1, R6.1, R7.1, S1.2, S2.2, S4.2, T1.3 (E), T2.3 (E), T3.3 (E), X1.2
LIGHT_L: ARDUINO1.D4, R9.2
LIGHT_R: ARDUINO1.D3, R10.2
L_E: ARDUINO1.D7, C3.2, R3.2, R4.2
L_F: ARDUINO1.D8, C2.2, R1.2, R2.2
MISO: ARDUINO1.D12, NRFL.2
MOSI: ARDUINO1.D11, NRFL.3
unnamed: R1.1, S1.1
unnamed: R3.1, S2.1
unnamed: R8.1, S4.1
unnamed: J3.1, R5.1
unnamed: F1.P$1 (1), X1.1
unnamed: J2.2, T1.4 (C)
unnamed: J4.2, T2.4 (C)
unnamed: J5.2, T3.4 (C)
unnamed: R11.1, T3.1 (B)
unnamed: R10.1, T2.1 (B)
unnamed: R9.1, T1.1 (B)
RX: ARDUINO1.RX, ARDUINO1.RX@1 (RX), J1.2
R_E: ARDUINO1.D5, C5.2, R7.2, R8.2
R_F: ARDUINO1.D6, C4.2, R5.2, R6.2
SCK: ARDUINO1.D13, NRFL.4
TX: ARDUINO1.TX, ARDUINO1.TX@1 (TX), J1.3
VALVE: ARDUINO1.D2, R11.2

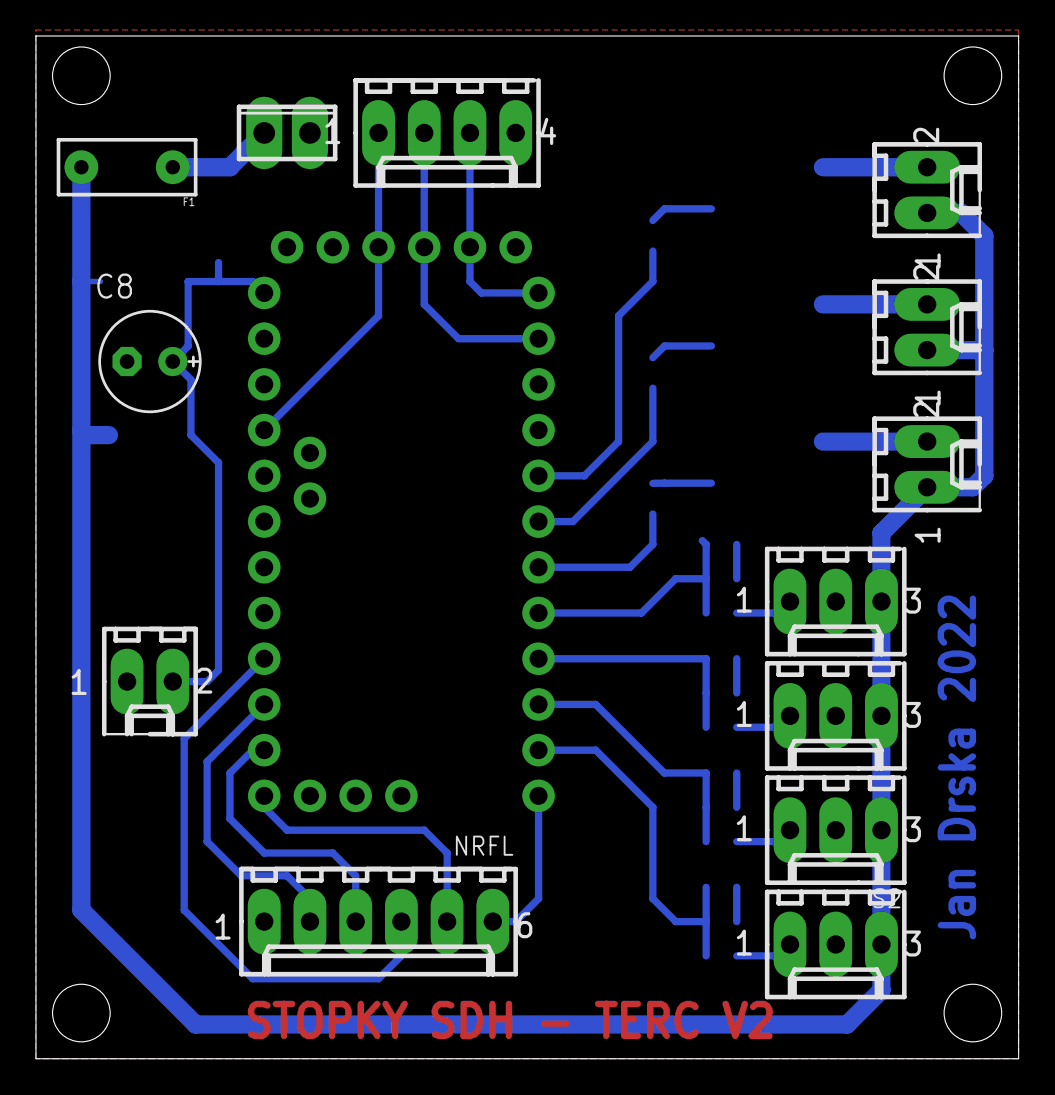
[picture p53: board TARGET.brd from above]

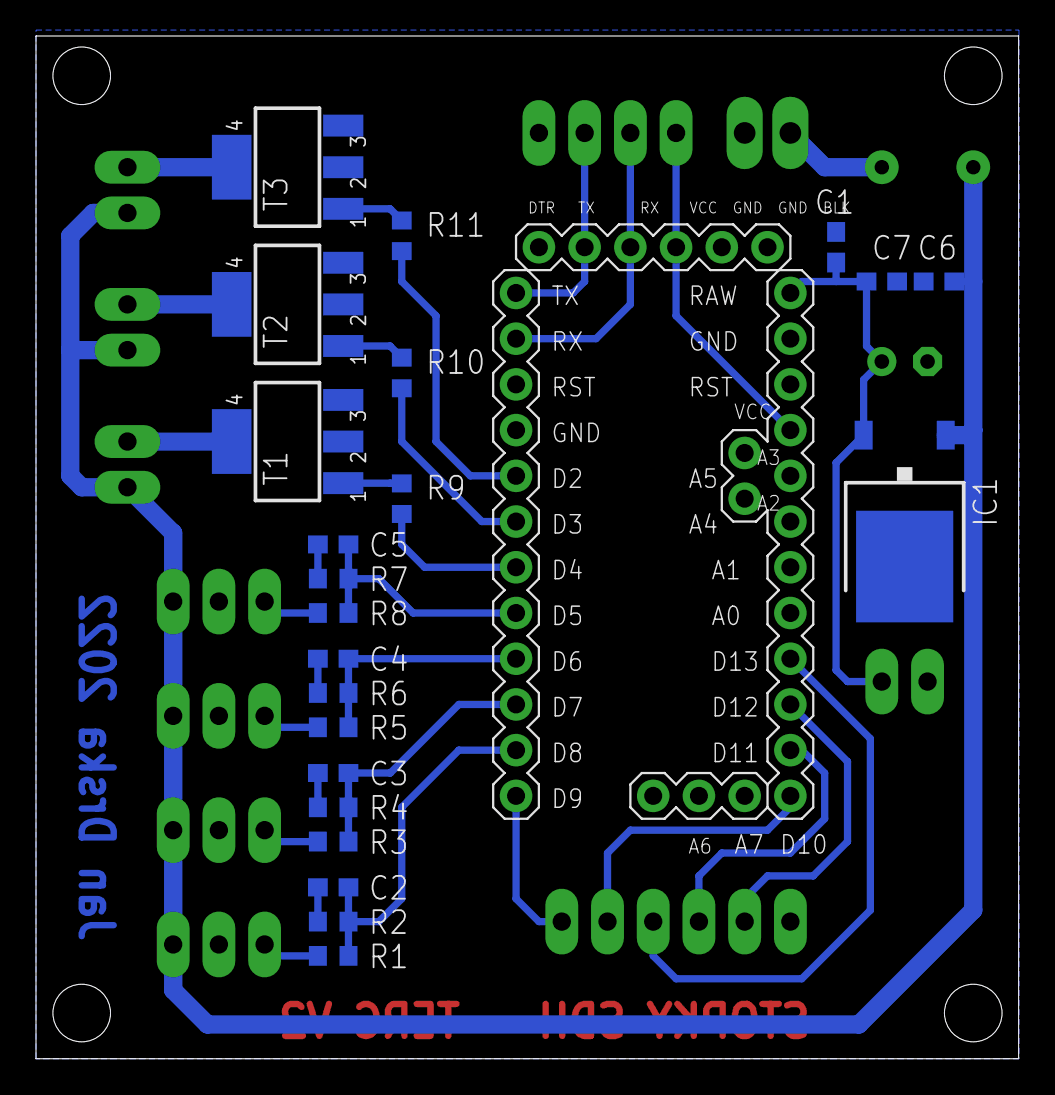
[picture p54: board TARGET.brd from below]

Board: 2 copper layers, 54.6 x 56.8 mm, 36 parts (23 on the bottom side), 29 nets.
