JanDrska/FIRESPORT-WATCH/HW/Eagle PCBs/7SEGMENT/7SEGMENT_V4.brd

## EAGLE design HW/Eagle PCBs/7SEGMENT/7SEGMENT_V4.brd (2022-05-29)

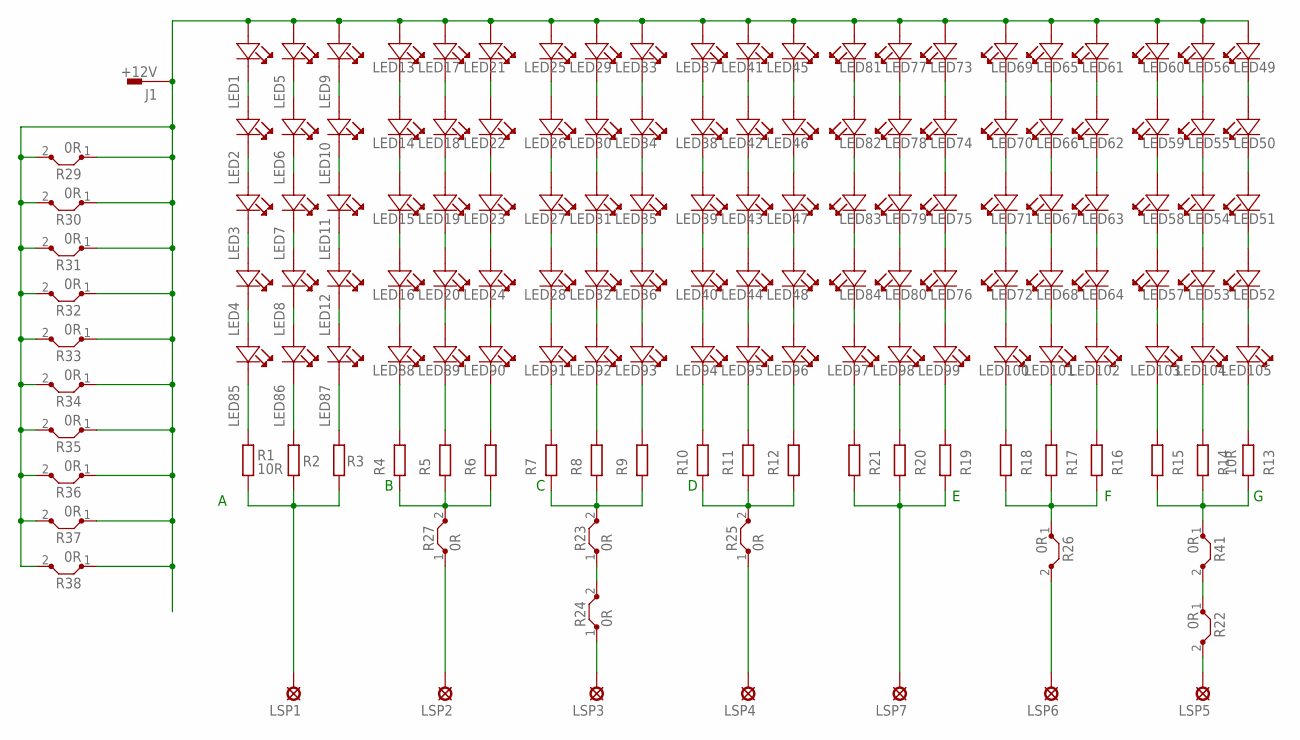
[picture p55: schematic 7SEGMENT_V4.sch]

Parts:
J1: +12V; F061.040
LED1, LED2, LED3, LED4, LED5, LED6, LED7, LED8, LED9, LED10, LED11, LED12, LED13, LED14, LED15, LED16, LED17, LED18, LED19, LED20, LED21, LED22, LED23, LED24, LED25, LED26, LED27, LED28, LED29, LED30, LED31, LED32, LED33, LED34, LED35, LED36, LED37, LED38, LED39, LED40, LED41, LED42, LED43, LED44, LED45, LED46, LED47, LED48, LED49, LED50, LED51, LED52, LED53, LED54, LED55, LED56, LED57, LED58, LED59, LED60, LED61, LED62, LED63, LED64, LED65, LED66, LED67, LED68, LED69, LED70, LED71, LED72, LED73, LED74, LED75, LED76, LED77, LED78, LED79, LED80, LED81, LED82, LED83, LED84, LED85, LED86, LED87, LED88, LED89, LED90, LED91, LED92, LED93, LED94, LED95, LED96, LED97, LED98, LED99, LED100, LED101, LED102, LED103, LED104, LED105: OF-SMD2835Y; LED_OF-SMD2835Y
LSP1: A; MCS08
LSP2: B; MCS08
LSP3: C; MCS08
LSP4: D; MCS08
LSP5: G; MCS08
LSP6: F; MCS08
LSP7: E; MCS08
R1, R13: 10R; R0603
R2, R3, R4, R5, R6, R7, R8, R9, R10, R11, R12, R14, R15, R16, R17, R18, R19, R20, R21: R-EU_R0603; R0603
R22, R23, R24, R25, R26, R27, R29, R30, R31, R32, R33, R34, R35, R36, R37, R38, R41: 0R; 05

Connections:
+12V: J1.A1 (1), LED1.1 (A), LED5.1 (A), LED9.1 (A), LED13.1 (A), LED17.1 (A), LED21.1 (A), LED25.1 (A), LED29.1 (A), LED33.1 (A), LED37.1 (A), LED41.1 (A), LED45.1 (A), LED49.1 (A), LED56.1 (A), LED60.1 (A), LED61.1 (A), LED65.1 (A), LED69.1 (A), LED73.1 (A), LED77.1 (A), LED81.1 (A), R29.1, R29.2, R30.1, R30.2, R31.1, R31.2, R32.1, R32.2, R33.1, R33.2, R34.1, R34.2, R35.1, R35.2, R36.1, R36.2, R37.1, R37.2, R38.1, R38.2
unnamed: LED1.2 (C), LED2.1 (A)
unnamed: LED2.2 (C), LED3.1 (A)
unnamed: LED3.2 (C), LED4.1 (A)
unnamed: LED5.2 (C), LED6.1 (A)
unnamed: LED6.2 (C), LED7.1 (A)
unnamed: LED7.2 (C), LED8.1 (A)
unnamed: LED9.2 (C), LED10.1 (A)
unnamed: LED10.2 (C), LED11.1 (A)
unnamed: LED11.2 (C), LED12.1 (A)
unnamed: LED13.2 (C), LED14.1 (A)
unnamed: LED14.2 (C), LED15.1 (A)
unnamed: LED15.2 (C), LED16.1 (A)
unnamed: LED17.2 (C), LED18.1 (A)
unnamed: LED18.2 (C), LED19.1 (A)
unnamed: LED19.2 (C), LED20.1 (A)
unnamed: LED21.2 (C), LED22.1 (A)
unnamed: LED22.2 (C), LED23.1 (A)
unnamed: LED23.2 (C), LED24.1 (A)
unnamed: LED25.2 (C), LED26.1 (A)
unnamed: LED26.2 (C), LED27.1 (A)
unnamed: LED27.2 (C), LED28.1 (A)
unnamed: LED29.2 (C), LED30.1 (A)
unnamed: LED30.2 (C), LED31.1 (A)
unnamed: LED31.2 (C), LED32.1 (A)
unnamed: LED33.2 (C), LED34.1 (A)
unnamed: LED34.2 (C), LED35.1 (A)
unnamed: LED35.2 (C), LED36.1 (A)
unnamed: LED37.2 (C), LED38.1 (A)
unnamed: LED38.2 (C), LED39.1 (A)
unnamed: LED39.2 (C), LED40.1 (A)
unnamed: LED41.2 (C), LED42.1 (A)
unnamed: LED42.2 (C), LED43.1 (A)
unnamed: LED43.2 (C), LED44.1 (A)
unnamed: LED45.2 (C), LED46.1 (A)
unnamed: LED46.2 (C), LED47.1 (A)
unnamed: LED47.2 (C), LED48.1 (A)
unnamed: LED49.2 (C), LED50.1 (A)
unnamed: LED85.2 (C), R1.2
unnamed: LED53.1 (A), LED54.2 (C)
unnamed: LED54.1 (A), LED55.2 (C)
unnamed: LSP5.MP, R22.2
unnamed: LED58.1 (A), LED59.2 (C)
unnamed: LED57.1 (A), LED58.2 (C)
unnamed: LED61.2 (C), LED62.1 (A)
unnamed: LED62.2 (C), LED63.1 (A)
unnamed: LED63.2 (C), LED64.1 (A)
unnamed: LED65.2 (C), LED66.1 (A)
unnamed: LED66.2 (C), LED67.1 (A)
unnamed: LED67.2 (C), LED68.1 (A)
unnamed: LED69.2 (C), LED70.1 (A)
unnamed: LED70.2 (C), LED71.1 (A)
unnamed: LED71.2 (C), LED72.1 (A)
unnamed: LED73.2 (C), LED74.1 (A)
unnamed: LED74.2 (C), LED75.1 (A)
unnamed: LED75.2 (C), LED76.1 (A)
unnamed: LED77.2 (C), LED78.1 (A)
unnamed: LED78.2 (C), LED79.1 (A)
unnamed: LED79.2 (C), LED80.1 (A)
unnamed: LED81.2 (C), LED82.1 (A)
unnamed: LED82.2 (C), LED83.1 (A)
unnamed: LED83.2 (C), LED84.1 (A)
unnamed: LED50.2 (C), LED51.1 (A)
unnamed: LED51.2 (C), LED52.1 (A)
unnamed: LED4.2 (C), LED85.1 (A)
unnamed: LED8.2 (C), LED86.1 (A)
unnamed: LED86.2 (C), R2.2
unnamed: LED87.2 (C), R3.2
unnamed: LED12.2 (C), LED87.1 (A)
unnamed: LED16.2 (C), LED88.1 (A)
unnamed: LED20.2 (C), LED89.1 (A)
unnamed: LED24.2 (C), LED90.1 (A)
unnamed: LED88.2 (C), R4.2
unnamed: LED89.2 (C), R5.2
unnamed: LED90.2 (C), R6.2
unnamed: LED28.2 (C), LED91.1 (A)
unnamed: LED32.2 (C), LED92.1 (A)
unnamed: LED55.1 (A), LED56.2 (C)
unnamed: LED59.1 (A), LED60.2 (C)
unnamed: LED36.2 (C), LED93.1 (A)
unnamed: LED40.2 (C), LED94.1 (A)
unnamed: LED44.2 (C), LED95.1 (A)
unnamed: LED48.2 (C), LED96.1 (A)
unnamed: LED84.2 (C), LED97.1 (A)
unnamed: LED80.2 (C), LED98.1 (A)
unnamed: LED76.2 (C), LED99.1 (A)
unnamed: R4.1, R5.1, R6.1, R27.2
unnamed: R7.1, R8.1, R9.1, R23.2
unnamed: R10.1, R11.1, R12.1, R25.2
unnamed: R22.1, R41.2
unnamed: R16.1, R17.1, R18.1, R26.1
unnamed: LSP1.MP, R1.1, R2.1, R3.1
unnamed: R13.1, R14.1, R15.1, R41.1
unnamed: LSP7.MP, R19.1, R20.1, R21.1
unnamed: LSP2.MP, R27.1
unnamed: LSP3.MP, R24.1
unnamed: LSP4.MP, R25.1
unnamed: R23.1, R24.2
unnamed: LSP6.MP, R26.2
unnamed: LED72.2 (C), LED100.1 (A)
unnamed: LED68.2 (C), LED101.1 (A)
unnamed: LED64.2 (C), LED102.1 (A)
unnamed: LED57.2 (C), LED103.1 (A)
unnamed: LED52.2 (C), LED105.1 (A)
unnamed: LED91.2 (C), R7.2
unnamed: LED92.2 (C), R8.2
unnamed: LED93.2 (C), R9.2
unnamed: LED94.2 (C), R10.2
unnamed: LED95.2 (C), R11.2
unnamed: LED96.2 (C), R12.2
unnamed: LED97.2 (C), R21.2
unnamed: LED98.2 (C), R20.2
unnamed: LED99.2 (C), R19.2
unnamed: LED100.2 (C), R18.2
unnamed: LED101.2 (C), R17.2
unnamed: LED102.2 (C), R16.2
unnamed: LED103.2 (C), R15.2
unnamed: LED104.2 (C), R14.2
unnamed: LED105.2 (C), R13.2
unnamed: LED53.2 (C), LED104.1 (A)

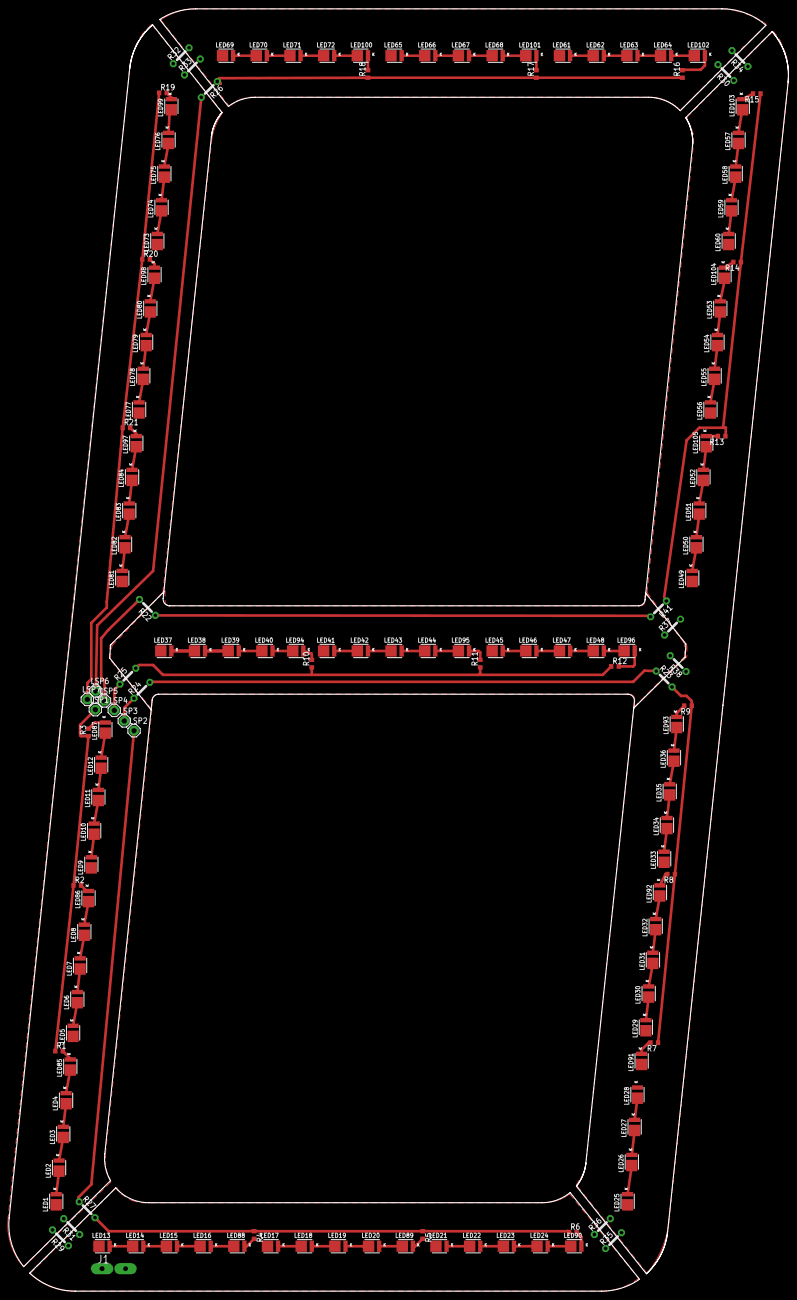
[picture p56: board 7SEGMENT_V4.brd from above]

Board: 2 copper layers, 176.3 x 290.0 mm, 151 parts (0 on the bottom side), 120 nets.
