JanDrska/FIRESPORT-WATCH/FW/USTREDNA_V2/src/sdhDisplay.cpp

#include "sdhDisplay.h"

void DisplaySdh::init()
{
  for(size_t i=0;i<=1;i++)
  {
    for(size_t i =0;i<8;i++)
    {
      PCF8574 pcf(I2C_address[i]);
      pcf.begin();
      pcf.write8(cislice[8]);
      //delay(250);
      }
    }

    delay (1000);

  for(size_t i=0;i<=1;i++)
  {
    for(size_t i =0;i<8;i++)
    {
      PCF8574 pcf(I2C_address[i]);
      pcf.begin();
      pcf.write8(znak[0]);
    }
  }
}

void DisplaySdh::initGraphical()
{
    // TODO nabeh dokola
}

void DisplaySdh::reset()
{
  for(size_t i=0;i<=1;i++)
  {
    for(size_t i =0;i<8;i++)
    {
      PCF8574 pcf(I2C_address[i]);
      pcf.begin();
      pcf.write8(cislice[0]);
    }
  }
}

void DisplaySdh::sendData(TimerData data1, TimerData data2)
{
//########################## MINUTY L ##############################
  split(splitTime,data1.casTERC_M);        
  I2C_write(splitTime[0],I2C_address[0]);
  I2C_write(splitTime[1],I2C_address[1]);
            
//########################## SEKUNDY L ##############################
  split(splitTime,data1.casTERC_S);         
  I2C_write(splitTime[0],I2C_address[2]);
  I2C_write(splitTime[1],I2C_address[3]);        

//########################## MINUTY R ##############################
  split(splitTime,data2.casTERC_M);            
  I2C_write(splitTime[0],I2C_address[4]);
  I2C_write(splitTime[1],I2C_address[5]);

//########################## SEKUNDY R ##############################         
  split(splitTime,data2.casTERC_S);            
  I2C_write(splitTime[0],I2C_address[6]);
  I2C_write(splitTime[1],I2C_address[7]);
}

void DisplaySdh::write8(int val,char flag)
{
  for(size_t i =0;i<8;i++)
  {
    PCF8574 pcf(I2C_address[i]);
    pcf.begin();
    if (flag == 'c')
      pcf.write8(znak[val]);
    else
      pcf.write8(cislice[val]);
  }
}

void DisplaySdh::I2C_write(int num,int address)
{
    PCF8574 pcf(address);
    pcf.write8(cislice[num]);
}

void DisplaySdh::split(int* DaM, int cas)  //funkce na splitTime dvoucifernych cisel
{
  DaM[0]= cas % 10; //jednotky
  if(((cas - DaM[0])/10)>=0)DaM[1] = (cas - DaM[0])/10; //desitky
  //else DaM[1];
}
