JanDrska/FIRESPORT-WATCH/FW/TERC_SDH/TERC V2/BG_sensor/utils.h

// coding: utf-8
// ----------------------------------------------------------------------------
/* Copyright (c) 2010, Roboterclub Aachen e.V.
 * All rights reserved.
 *
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
 *  * Redistributions of source code must retain the above copyright
 *    notice, this list of conditions and the following disclaimer.
 *  * Redistributions in binary form must reproduce the above copyright
 *    notice, this list of conditions and the following disclaimer in the
 *    documentation and/or other materials provided with the distribution.
 *  * Neither the name of the Roboterclub Aachen e.V. nor the
 *    names of its contributors may be used to endorse or promote products
 *    derived from this software without specific prior written permission.
 *
 * THIS SOFTWARE IS PROVIDED BY ROBOTERCLUB AACHEN E.V. ''AS IS'' AND ANY
 * EXPRESS OR IMPLIED WARRANTIES, INCLUDING, BUT NOT LIMITED TO, THE IMPLIED
 * WARRANTIES OF MERCHANTABILITY AND FITNESS FOR A PARTICULAR PURPOSE ARE
 * DISCLAIMED. IN NO EVENT SHALL ROBOTERCLUB AACHEN E.V. BE LIABLE FOR ANY
 * DIRECT, INDIRECT, INCIDENTAL, SPECIAL, EXEMPLARY, OR CONSEQUENTIAL DAMAGES
 * (INCLUDING, BUT NOT LIMITED TO, PROCUREMENT OF SUBSTITUTE GOODS OR SERVICES;
 * LOSS OF USE, DATA, OR PROFITS; OR BUSINESS INTERRUPTION) HOWEVER CAUSED AND
 * ON ANY THEORY OF LIABILITY, WHETHER IN CONTRACT, STRICT LIABILITY, OR TORT
 * (INCLUDING NEGLIGENCE OR OTHERWISE) ARISING IN ANY WAY OUT OF THE USE OF
 * THIS SOFTWARE, EVEN IF ADVISED OF THE POSSIBILITY OF SUCH DAMAGE.
 *
 * $Id$
 */
// ----------------------------------------------------------------------------

#ifndef	UTILS_H
#define	UTILS_H

// ----------------------------------------------------------------------------
/**
 * \defgroup utils_h Gruppe nützlicher Makros und Inline-Funktionen
 * \brief	Nützliche Makros und Funktionen.
 *
 * \version	$Id: utils.h 8541 2010-03-15 22:01:12Z fabian $
 */
// ----------------------------------------------------------------------------

#include <avr/io.h>
#include <avr/interrupt.h>

//#include "config.h"

// ----------------------------------------------------------------------------

#ifndef	TRUE
	#define	TRUE	(1==1)
#elif !TRUE
	#error	fehlerhafte Definition fuer TRUE
#endif

#ifndef FALSE
	#define	FALSE	(1!=1)
#elif FALSE
	#error	fehlerhafte Definition fuer FALSE
#endif

#ifndef NULL
	#define NULL ((void*)0)		//!< Nullzeiger
#endif

// ----------------------------------------------------------------------------
/**
 * \ingroup	utils_h
 * \name	Nützliches
 */
//@{

#define	LOW_BYTE(x)		((uint8_t) (x & 0xff))
#define	HIGH_BYTE(x)	((uint8_t) (x >> 8))
#define LOW_WORD(x)		((uint16_t) (x & 0xffff))
#define HIGH_WORD(x)    ((uint16_t) (x >> 16))

//@}
// ----------------------------------------------------------------------------
/**
 * \ingroup	utils_h
 * \name	Port-Makros
 *
 * Die Makros RESET(), SET(), SET_OUTPUT(), SET_INPUT() und IS_SET()
 * beziehen sich immer auf ein bestimmtes Bit eines Ports und helfen somit
 * den Code sehr portabel zu gestalten.
 *
 * Beispiel:
 * \code
 * #define LED   D,5		// PORTD, Pin 5
 *
 * SET_OUTPUT(LED);		// Pin als Ausgang schalten (wird z.B. zu DDRD |= (1<<5);)
 * 
 * SET(LED);				// LED aktivieren
 * \endcode
 *
 * oder auch:
 *
 * \code
 * #define SCHALTER   B,1		// PORTB, Pin 1
 * 
 * SET_INPUT_WITH_PULLUP(SCHALTER);
 * 
 * if (IS_SET(SCHALTER)) {
 * 		...
 * }
 * \endcode
 * 
 * Somit muss nur ein Define geändert werden sobald ein anderer Pin verwendet
 * werden soll. Außerdem muss nicht immer noch ein extra Define für den 
 * entsprechenden Port angelegt werden wie es bisher immer der Fall war.
 */
//@{
#if defined(__DOXYGEN__)

#define RESET(x)		//!< Einzelnes Bit eines bestimmten Ports setzen
#define SET(x)			//!< Bit löschen
#define	TOGGLE(x)		//!< Bit umschalten

#define	SET_OUTPUT(x)	//!< Einzeles Bit ein Port als Ausgang schalten
#define	SET_INPUT(x)	//!< Bit als Eingang schalten
#define	SET_PULLUP(x)	//!< aktiviert den Pullup eines Pins (nur falls dieser als Eingang geschaltet ist)

#define	IS_SET(x)		//!< Zustand eines Eingangs abfragen

#else /* !DOXYGEN */

/* Warum hier zum Teil so seltsame Konstrukte notwendig sind wird zum Beispiel
 * in http://www.mikrocontroller.net/forum/read-1-324854.html#324980 erklärt.
 */
#define	PORT(x)			_port2(x)
#define	DDR(x)			_ddr2(x)
#define	PIN(x)			_pin2(x)
#define	REG(x)			_reg(x)
#define	PIN_NUM(x)		_pin_num(x)

#define	RESET(x)		RESET2(x)
#define	SET(x)			SET2(x)
#define	TOGGLE(x)		TOGGLE2(x)
#define	SET_OUTPUT(x)	SET_OUTPUT2(x)
#define	SET_INPUT(x)	SET_INPUT2(x)
#define	SET_PULLUP(x)	SET2(x)
#define	IS_SET(x)		IS_SET2(x)

#define	_port2(x)	PORT ## x
#define	_ddr2(x)	DDR ## x
#define	_pin2(x)	PIN ## x

#define	_reg(x,y)		x
#define	_pin_num(x,y)	y

#define	RESET2(x,y)		PORT(x).OUTCLR = (1<<y)
#define	SET2(x,y)		PORT(x).OUTSET = (1<<y)
#define	TOGGLE2(x,y)	PORT(x).OUTTGL = (1<<y)

#define	SET_OUTPUT2(x,y)	PORT(x).DIR |= (1<<y)
#define	SET_INPUT2(x,y)		PORT(x).DIR &= ~(1<<y)

#define	IS_SET2(x,y)	((PORT(x).IN & (1<<y)) != 0)

#endif /* DOXYGEN */
//@}


#endif	// UTILS_H
