JanDrska/FIRESPORT-WATCH/(commit log)

2022-05-13 oprava bug - nrf024l
    [main.cpp]
2022-05-14 ovl panel pridani prikazu a LED
2022-05-29 nahrani dokumentace HW
    [OVL_PANEL.brd, OVL_PANEL.sch, SEGMENTOVKA_I2C.brd, SEGMENTOVKA_I2C.sch, SEGMENTOVKA_V4.brd, SEGMENTOVKA_V4.sch, TERC_IO_V2.brd, TERC_IO_V2.sch]
2022-05-29 nahrani ENG nazvu souboru
    [7SEGMENT_I2C.brd, 7SEGMENT_I2C.sch, 7SEGMENT_V4.brd, 7SEGMENT_V4.sch, CTRL_PANEL.brd, CTRL_PANEL.sch, MAIN_UNIT.brd, MAIN_UNIT.sch]
